Gekkio/gekkio-kicad-libs/README.markdown

# KiCad 10.x libraries by gekkio

Licensed under Creative Commons Attribution 4.0 International.

## Symbols

<!-- SYMBOLS START -->
| Name | Description | Datasheet |
| - | - | - |
| 10M02SCE144 | MAX 10 FPGA, 2000 LE, single supply, EQFP-144 | [Datasheet](https://www.intel.com/content/dam/www/programmable/us/en/pdfs/literature/hb/max-10/m10_overview.pdf) |
| 10M04DAF256 | MAX 10 FPGA, 4000 LE, dual supply, analog and flash, FBGA-256 | [Datasheet](https://www.intel.com/content/dam/www/programmable/us/en/pdfs/literature/hb/max-10/m10_overview.pdf) |
| 10M04SAE144 | MAX 10 FPGA, 4000 LE, single supply, analog and flash, EQFP-144 | [Datasheet](https://www.intel.com/content/dam/www/programmable/us/en/pdfs/literature/hb/max-10/m10_overview.pdf) |
| 10M04SCE144 | MAX 10 FPGA, 4000 LE, single supply, EQFP-144 | [Datasheet](https://www.intel.com/content/dam/www/programmable/us/en/pdfs/literature/hb/max-10/m10_overview.pdf) |
| 10M08DAF256 | MAX 10 FPGA, 8000 LE, dual supply, analog and flash, FBGA-256 | [Datasheet](https://www.intel.com/content/dam/www/programmable/us/en/pdfs/literature/hb/max-10/m10_overview.pdf) |
| 10M08SAE144 | MAX 10 FPGA, 8000 LE, single supply, analog and flash, EQFP-144 | [Datasheet](https://www.intel.com/content/dam/www/programmable/us/en/pdfs/literature/hb/max-10/m10_overview.pdf) |
| 10M08SCE144 | MAX 10 FPGA, 8000 LE, single supply, EQFP-144 | [Datasheet](https://www.intel.com/content/dam/www/programmable/us/en/pdfs/literature/hb/max-10/m10_overview.pdf) |
| 10M16DAF256 | MAX 10 FPGA, 16000 LE, dual supply, analog and flash, FBGA-256 | [Datasheet](https://www.intel.com/content/dam/www/programmable/us/en/pdfs/literature/hb/max-10/m10_overview.pdf) |
| 10M16SAE144 | MAX 10 FPGA, 16000 LE, single supply, analog and flash, EQFP-144 | [Datasheet](https://www.intel.com/content/dam/www/programmable/us/en/pdfs/literature/hb/max-10/m10_overview.pdf) |
| 10M16SCE144 | MAX 10 FPGA, 16000 LE, single supply, EQFP-144 | [Datasheet](https://www.intel.com/content/dam/www/programmable/us/en/pdfs/literature/hb/max-10/m10_overview.pdf) |
| 10M25DAF256 | MAX 10 FPGA, 25000 LE, dual supply, analog and flash, FBGA-256 | [Datasheet](https://www.intel.com/content/dam/www/programmable/us/en/pdfs/literature/hb/max-10/m10_overview.pdf) |
| 10M25SAE144 | MAX 10 FPGA, 25000 LE, single supply, analog and flash, EQFP-144 | [Datasheet](https://www.intel.com/content/dam/www/programmable/us/en/pdfs/literature/hb/max-10/m10_overview.pdf) |
| 10M25SCE144 | MAX 10 FPGA, 25000 LE, single supply, EQFP-144 | [Datasheet](https://www.intel.com/content/dam/www/programmable/us/en/pdfs/literature/hb/max-10/m10_overview.pdf) |
| 10M40DAF256 | MAX 10 FPGA, 40000 LE, dual supply, analog and flash, FBGA-256 | [Datasheet](https://www.intel.com/content/dam/www/programmable/us/en/pdfs/literature/hb/max-10/m10_overview.pdf) |
| 10M50DAF256 | MAX 10 FPGA, 50000 LE, dual supply, analog and flash, FBGA-256 | [Datasheet](https://www.intel.com/content/dam/www/programmable/us/en/pdfs/literature/hb/max-10/m10_overview.pdf) |
| 1SS294 | 40V 0.1A Small signal Schottky diode, SOT-23 | [Datasheet](https://toshiba.semicon-storage.com/info/docget.jsp?did=3290&prodName=1SS294) |
| 23K256xSN | 256k SPI Bus Low-Power Serial SRAM, SOIC-8 | [Datasheet](http://ww1.microchip.com/downloads/en/DeviceDoc/22100F.pdf) |
| 23K256xST | 256k SPI Bus Low-Power Serial SRAM, TSSOP-8 | [Datasheet](http://ww1.microchip.com/downloads/en/DeviceDoc/22100F.pdf) |
| 5M160ZE64 | MAX V CPLD, 160 LE, EQFP-64 | [Datasheet](https://www.intel.com/content/dam/www/programmable/us/en/pdfs/literature/hb/max-v/mv51001.pdf) |
| 5M40ZE64 | MAX V CPLD, 40 LE, EQFP-64 | [Datasheet](https://www.intel.com/content/dam/www/programmable/us/en/pdfs/literature/hb/max-v/mv51001.pdf) |
| 5M80ZE64 | MAX V CPLD, 80 LE, EQFP-64 | [Datasheet](https://www.intel.com/content/dam/www/programmable/us/en/pdfs/literature/hb/max-v/mv51001.pdf) |
| 74AXP4T245PW | 4-bit dual supply translating transceiver, 3-state, TSSOP-16 | [Datasheet](https://assets.nexperia.com/documents/data-sheet/74LVC_LVCH8T245.pdf) |
| 74AXP8T245PW | 8-bit dual supply translating transceiver, 3-state, TSSOP-24 | [Datasheet](https://assets.nexperia.com/documents/data-sheet/74LVC_LVCH8T245.pdf) |
| 74LV1T125GV | Single supply translating buffer/line driver, 3-state, SOT-23-5 | [Datasheet](https://assets.nexperia.com/documents/data-sheet/74LV1T125.pdf) |
| 74LV1T125GW | Single supply translating buffer/line driver, 3-state, SC-70-5 | [Datasheet](https://assets.nexperia.com/documents/data-sheet/74LV1T125.pdf) |
| 74LV1T126GV | Single supply translating buffer/line driver, 3-state, SOT-23-5 | [Datasheet](https://assets.nexperia.com/documents/data-sheet/74LV1T126.pdf) |
| 74LV1T126GW | Single supply translating buffer/line driver, 3-state, SC-70-5 | [Datasheet](https://assets.nexperia.com/documents/data-sheet/74LV1T126.pdf) |
| 74LVC125APW | Quad buffer/line driver, 3-state, TSSOP-14 | [Datasheet](https://assets.nexperia.com/documents/data-sheet/74LVC125A.pdf) |
| 74LVC126APW | Quad buffer/line driver, 3-state, TSSOP-14 | [Datasheet](https://assets.nexperia.com/documents/data-sheet/74LVC126A.pdf) |
| 74LVC16244ADGG | 16-bit buffer/line driver, 5V input/output tolerant, 3-state, TSSOP-48 | [Datasheet](https://assets.nexperia.com/documents/data-sheet/74LVC_LVCH16244A.pdf) |
| 74LVC16373ADGG | 16-bit D-type transparent latch with 5V tolerant inputs/outputs, 3-state, TSSOP-48 | [Datasheet](https://assets.nexperia.com/documents/data-sheet/74LVC_LVCH16373A.pdf) |
| 74LVC16373ADGV | 16-bit D-type transparent latch with 5V tolerant inputs/outputs, 3-state, TSSOP-48 | [Datasheet](https://assets.nexperia.com/documents/data-sheet/74LVC_LVCH16373A.pdf) |
| 74LVC16373ADL | 16-bit D-type transparent latch with 5V tolerant inputs/outputs, 3-state, SSOP-48 | [Datasheet](https://assets.nexperia.com/documents/data-sheet/74LVC_LVCH16373A.pdf) |
| 74LVC1G157GW | Single 2-input multiplexer, SOT-363 | [Datasheet](https://assets.nexperia.com/documents/data-sheet/74LVC1G157.pdf) |
| 74LVC244APW | Octal buffer/line driver, 3-state, TSSOP-20 | [Datasheet](https://assets.nexperia.com/documents/data-sheet/74LVC_LVCH244A.pdf) |
| 74LVC245APW | Octal bus transceiver, 3-state, TSSOP-20 | [Datasheet](https://assets.nexperia.com/documents/data-sheet/74LVC_LVCH245A.pdf) |
| 74LVC32AD | Quad 2-input OR gate, SO-14 | [Datasheet](https://assets.nexperia.com/documents/data-sheet/74LVC32A.pdf) |
| 74LVC32ADB | Quad 2-input OR gate, SSOP-14 | [Datasheet](https://assets.nexperia.com/documents/data-sheet/74LVC32A.pdf) |
| 74LVC32APW | Quad 2-input OR gate, TSSOP-14 | [Datasheet](https://assets.nexperia.com/documents/data-sheet/74LVC32A.pdf) |
| 74LVC4T3144PW | 4-bit dual supply buffer/line driver; 3-state | [Datasheet](https://assets.nexperia.com/documents/data-sheet/74LVC4T3144.pdf) |
| 74LVC540APW | Octal inverting buffer/line driver, 3-state, TSSOP-20 | [Datasheet](https://www.ti.com/lit/ds/symlink/sn74lvc540a.pdf) |
| 74LVC573ABQ | Octal D-type transparent latch with 5 V tolerant inputs/outputs, 3-state, DHVQFN-20 | [Datasheet](https://assets.nexperia.com/documents/data-sheet/74LVC573A.pdf) |
| 74LVC573AD | Octal D-type transparent latch with 5 V tolerant inputs/outputs, 3-state, SO-20 | [Datasheet](https://assets.nexperia.com/documents/data-sheet/74LVC573A.pdf) |
| 74LVC573ADB | Octal D-type transparent latch with 5 V tolerant inputs/outputs, 3-state, SSOP-20 | [Datasheet](https://assets.nexperia.com/documents/data-sheet/74LVC573A.pdf) |
| 74LVC573APW | Octal D-type transparent latch with 5 V tolerant inputs/outputs, 3-state, TSSOP-20 | [Datasheet](https://assets.nexperia.com/documents/data-sheet/74LVC573A.pdf) |
| 74LVC594AD | 8-bit shift register with output register, SO-16 | [Datasheet](https://assets.nexperia.com/documents/data-sheet/74LVC594A.pdf) |
| 74LVC594APW | 8-bit shift register with output register, TSSOP-16 | [Datasheet](https://assets.nexperia.com/documents/data-sheet/74LVC594A.pdf) |
| 74LVC595AD | 8-bit serial-in/serial-out or parallel-out shift register, 3-state, SO-16 | [Datasheet](https://assets.nexperia.com/documents/data-sheet/74LVC595A.pdf) |
| 74LVC595APW | 8-bit serial-in/serial-out or parallel-out shift register, 3-state, TSSOP-16 | [Datasheet](https://assets.nexperia.com/documents/data-sheet/74LVC595A.pdf) |
| 74LVC8T245PW | 8-bit dual supply translating transceiver, 3-state, TSSOP-24 | [Datasheet](https://assets.nexperia.com/documents/data-sheet/74LVC_LVCH8T245.pdf) |
| 74LVCH16244ADGG | 16-bit buffer/line driver, 5V input/output tolerant, 3-state, bus hold, TSSOP-48 | [Datasheet](https://assets.nexperia.com/documents/data-sheet/74LVC_LVCH16244A.pdf) |
| 74LVCH16373ADGG | 16-bit D-type transparent latch with 5V tolerant inputs/outputs, 3-state, bus hold, TSSOP-48 | [Datasheet](https://assets.nexperia.com/documents/data-sheet/74LVC_LVCH16373A.pdf) |
| 74LVCH16373ADGV | 16-bit D-type transparent latch with 5V tolerant inputs/outputs, 3-state, bus hold, TSSOP-48 | [Datasheet](https://assets.nexperia.com/documents/data-sheet/74LVC_LVCH16373A.pdf) |
| 74LVCH16373ADL | 16-bit D-type transparent latch with 5V tolerant inputs/outputs, 3-state, bus hold, SSOP-48 | [Datasheet](https://assets.nexperia.com/documents/data-sheet/74LVC_LVCH16373A.pdf) |
| 74LVCH244APW | Octal buffer/line driver, 3-state, bus hold, TSSOP-20 | [Datasheet](https://assets.nexperia.com/documents/data-sheet/74LVC_LVCH244A.pdf) |
| 74LVCH245APW | Octal bus transceiver, 3-state, bus hold, TSSOP-20 | [Datasheet](https://assets.nexperia.com/documents/data-sheet/74LVC_LVCH245A.pdf) |
| 74LVCH8T245PW | 8-bit dual supply translating transceiver, 3-state, bus hold, TSSOP-24 | [Datasheet](https://assets.nexperia.com/documents/data-sheet/74LVC_LVCH8T245.pdf) |
| 74VHC125PW | Quad buffer/line driver, 3-state, TSSOP-14 | [Datasheet](https://assets.nexperia.com/documents/data-sheet/74VHC_VHCT125.pdf) |
| 74VHC126PW | Quad buffer/line driver, 3-state, TSSOP-14 | [Datasheet](https://assets.nexperia.com/documents/data-sheet/74VHC_VHCT126.pdf) |
| 74VHCT125PW | Quad buffer/line driver, 3-state, TSSOP-14 | [Datasheet](https://assets.nexperia.com/documents/data-sheet/74VHC_VHCT125.pdf) |
| 74VHCT126PW | Quad buffer/line driver, 3-state, TSSOP-14 | [Datasheet](https://assets.nexperia.com/documents/data-sheet/74VHC_VHCT126.pdf) |
| 93LC56A-xOT | 2kb (256 x 8) 2.5V Microwire Compatible Serial EEPROM, SOT-23-6 | [Datasheet](http://ww1.microchip.com/downloads/en/devicedoc/21794b.pdf) |
| 93LC56B-xOT | 2kb (128 x 16) 2.5V Microwire Compatible Serial EEPROM, SOT-23-6 | [Datasheet](http://ww1.microchip.com/downloads/en/devicedoc/21794b.pdf) |
| AD8428 | Single Low Noise, Low Gain Drift, G=2000 Instrumentation Amplifier, SOIC-8 | [Datasheet](https://www.analog.com/media/en/technical-documentation/data-sheets/AD8428.PDF) |
| AD8428ARZ | Single Low Noise, Low Gain Drift, G=2000 Instrumentation Amplifier, A Grade, SOIC-8 | [Datasheet](https://www.analog.com/media/en/technical-documentation/data-sheets/AD8428.PDF) |
| AD8428BRZ | Single Low Noise, Low Gain Drift, G=2000 Instrumentation Amplifier, B Grade, SOIC-8 | [Datasheet](https://www.analog.com/media/en/technical-documentation/data-sheets/AD8428.PDF) |
| ADS1274 | Quad, Simultaneous Sampling, 24-Bit Analog-to-Digital Converters, HTQFP-64 | [Datasheet](http://www.ti.com/lit/ds/symlink/ads1274.pdf) |
| ADS1278 | Octal, Simultaneous Sampling, 24-Bit Analog-to-Digital Converters, HTQFP-64 | [Datasheet](http://www.ti.com/lit/ds/symlink/ads1278.pdf) |
| AP2114H-1.2 | 1.2V 1A Low Noise CMOS LDO Regulator, SOT-223 | [Datasheet](https://www.diodes.com/assets/Datasheets/AP2114.pdf) |
| AP2114H-1.5 | 1.5V 1A Low Noise CMOS LDO Regulator, SOT-223 | [Datasheet](https://www.diodes.com/assets/Datasheets/AP2114.pdf) |
| AP2114H-1.8 | 1.8V 1A Low Noise CMOS LDO Regulator, SOT-223 | [Datasheet](https://www.diodes.com/assets/Datasheets/AP2114.pdf) |
| AP2114H-2.5 | 2.5V 1A Low Noise CMOS LDO Regulator, SOT-223 | [Datasheet](https://www.diodes.com/assets/Datasheets/AP2114.pdf) |
| AP2114H-3.3 | 3.3V 1A Low Noise CMOS LDO Regulator, SOT-223 | [Datasheet](https://www.diodes.com/assets/Datasheets/AP2114.pdf) |
| AP2138N-1.2 | 1.2V 250mA Ultra Low Quiescent Current CMOS LDO, SOT-23-3 | [Datasheet](https://www.diodes.com/assets/Datasheets/AP2138-9.pdf) |
| AP2138N-1.4 | 1.4V 250mA Ultra Low Quiescent Current CMOS LDO, SOT-23-3 | [Datasheet](https://www.diodes.com/assets/Datasheets/AP2138-9.pdf) |
| AP2138N-1.5 | 1.5V 250mA Ultra Low Quiescent Current CMOS LDO, SOT-23-3 | [Datasheet](https://www.diodes.com/assets/Datasheets/AP2138-9.pdf) |
| AP2138N-1.8 | 1.8V 250mA Ultra Low Quiescent Current CMOS LDO, SOT-23-3 | [Datasheet](https://www.diodes.com/assets/Datasheets/AP2138-9.pdf) |
| AP2138N-2.1 | 2.1V 250mA Ultra Low Quiescent Current CMOS LDO, SOT-23-3 | [Datasheet](https://www.diodes.com/assets/Datasheets/AP2138-9.pdf) |
| AP2138N-2.2 | 2.2V 250mA Ultra Low Quiescent Current CMOS LDO, SOT-23-3 | [Datasheet](https://www.diodes.com/assets/Datasheets/AP2138-9.pdf) |
| AP2138N-2.5 | 2.5V 250mA Ultra Low Quiescent Current CMOS LDO, SOT-23-3 | [Datasheet](https://www.diodes.com/assets/Datasheets/AP2138-9.pdf) |
| AP2138N-2.8 | 2.8V 250mA Ultra Low Quiescent Current CMOS LDO, SOT-23-3 | [Datasheet](https://www.diodes.com/assets/Datasheets/AP2138-9.pdf) |
| AP2138N-3.0 | 3.0V 250mA Ultra Low Quiescent Current CMOS LDO, SOT-23-3 | [Datasheet](https://www.diodes.com/assets/Datasheets/AP2138-9.pdf) |
| AP2138N-3.3 | 3.3V 250mA Ultra Low Quiescent Current CMOS LDO, SOT-23-3 | [Datasheet](https://www.diodes.com/assets/Datasheets/AP2138-9.pdf) |
| AP2138N-3.6 | 3.6V 250mA Ultra Low Quiescent Current CMOS LDO, SOT-23-3 | [Datasheet](https://www.diodes.com/assets/Datasheets/AP2138-9.pdf) |
| AP2139AK-1.2 | 1.2V 250mA Ultra Low Quiescent Current CMOS LDO, Active High Enable with Quick Discharge, SOT-23-5 | [Datasheet](https://www.diodes.com/assets/Datasheets/AP2138-9.pdf) |
| AP2139AK-1.4 | 1.4V 250mA Ultra Low Quiescent Current CMOS LDO, Active High Enable with Quick Discharge, SOT-23-5 | [Datasheet](https://www.diodes.com/assets/Datasheets/AP2138-9.pdf) |
| AP2139AK-1.5 | 1.5V 250mA Ultra Low Quiescent Current CMOS LDO, Active High Enable with Quick Discharge, SOT-23-5 | [Datasheet](https://www.diodes.com/assets/Datasheets/AP2138-9.pdf) |
| AP2139AK-1.8 | 1.8V 250mA Ultra Low Quiescent Current CMOS LDO, Active High Enable with Quick Discharge, SOT-23-5 | [Datasheet](https://www.diodes.com/assets/Datasheets/AP2138-9.pdf) |
| AP2139AK-2.5 | 2.5V 250mA Ultra Low Quiescent Current CMOS LDO, Active High Enable with Quick Discharge, SOT-23-5 | [Datasheet](https://www.diodes.com/assets/Datasheets/AP2138-9.pdf) |
| AP2139AK-2.8 | 2.8V 250mA Ultra Low Quiescent Current CMOS LDO, Active High Enable with Quick Discharge, SOT-23-5 | [Datasheet](https://www.diodes.com/assets/Datasheets/AP2138-9.pdf) |
| AP2139AK-3.0 | 3.0V 250mA Ultra Low Quiescent Current CMOS LDO, Active High Enable with Quick Discharge, SOT-23-5 | [Datasheet](https://www.diodes.com/assets/Datasheets/AP2138-9.pdf) |
| AP2139AK-3.3 | 3.3V 250mA Ultra Low Quiescent Current CMOS LDO, Active High Enable with Quick Discharge, SOT-23-5 | [Datasheet](https://www.diodes.com/assets/Datasheets/AP2138-9.pdf) |
| AP2205-18W5-7 | 1.8V, 200mA, wide input voltage range ULDO regulator, SOT-23-5 | [Datasheet](https://www.diodes.com/assets/Datasheets/AP2205.pdf) |
| AP3019AK | White LED step-up converter, SOT-23-6 | [Datasheet](https://www.diodes.com/assets/Datasheets/AP3019A.pdf) |
| AP3019AKT | White LED step-up converter, TSOT-23-6 | [Datasheet](https://www.diodes.com/assets/Datasheets/AP3019A.pdf) |
| AP4953GM | Dual P-Channel Enchancement Mode MOSFET, SOIC-8 | [Datasheet](https://datasheet.lcsc.com/szlcsc/Advanced-Power-Elec-AP4953GM_C6193.pdf) |
| AP61100 | 2.3V to 5.5V Input, 1A Low IQ Synchronous Buck Converter, SOT-563 | [Datasheet](https://www.diodes.com/assets/Datasheets/AP61100-AP61102.pdf) |
| AP61102 | 2.3V to 5.5V Input, 1A Low IQ Synchronous Buck Converter, with Power Good, SOT-563 | [Datasheet](https://www.diodes.com/assets/Datasheets/AP61100-AP61102.pdf) |
| AS4C16M16SA | 256Mb (16M x 16) Synchronous DRAM, TSOP-II 54-pin | [Datasheet](https://www.alliancememory.com/wp-content/uploads/pdf/dram/256Mb-AS4C16M16SA-C&I_V3.0_March%202015.pdf) |
| AT49F001-xxJx | 1Mb (128K x 8) 5-volt Only Flash Memory, PLCC-32 | [Datasheet](https://datasheet.octopart.com/AT49F001-55PC-Atmel-datasheet-10108.pdf) |
| AT49F001N-xxJx | 1Mb (128K x 8) 5-volt Only Flash Memory, PLCC-32 | [Datasheet](https://datasheet.octopart.com/AT49F001-55PC-Atmel-datasheet-10108.pdf) |
| AT49F001NT-xxJx | 1Mb (128K x 8) 5-volt Only Flash Memory, PLCC-32 | [Datasheet](https://datasheet.octopart.com/AT49F001-55PC-Atmel-datasheet-10108.pdf) |
| AT49F001T-xxJx | 1Mb (128K x 8) 5-volt Only Flash Memory, PLCC-32 | [Datasheet](https://datasheet.octopart.com/AT49F001-55PC-Atmel-datasheet-10108.pdf) |
| AT49F002-xxJx | 2Mb (256K x 8) 5-volt Only Flash Memory, PLCC-32 | [Datasheet](https://datasheet.octopart.com/AT49F002T-90JC-Atmel-datasheet-821.pdf) |
| AT49F002N-xxJx | 2Mb (256K x 8) 5-volt Only Flash Memory, PLCC-32 | [Datasheet](https://datasheet.octopart.com/AT49F002T-90JC-Atmel-datasheet-821.pdf) |
| AT49F002NT-xxJx | 2Mb (256K x 8) 5-volt Only Flash Memory, PLCC-32 | [Datasheet](https://datasheet.octopart.com/AT49F002T-90JC-Atmel-datasheet-821.pdf) |
| AT49F002T-xxJx | 2Mb (256K x 8) 5-volt Only Flash Memory, PLCC-32 | [Datasheet](https://datasheet.octopart.com/AT49F002T-90JC-Atmel-datasheet-821.pdf) |
| ATA6561-GAQW | High-Speed CAN Transceiver with Standby Mode, CAN FD Ready, SOIC-8 | [Datasheet](https://ww1.microchip.com/downloads/en/DeviceDoc/20005991B.pdf) |
| ATF1504AS-xAx100 | High-performance Complex Programmable Logic Device, 64 Macrocells, TQFP-100 | [Datasheet](http://ww1.microchip.com/downloads/en/DeviceDoc/doc0784.pdf) |
| ATF1504ASL-xAx100 | High-performance Complex Programmable Logic Device, 64 Macrocells, TQFP-100 | [Datasheet](http://ww1.microchip.com/downloads/en/DeviceDoc/doc0784.pdf) |
| ATF1508AS-xAx100 | High-performance Complex Programmable Logic Device, 128 Macrocells, TQFP-100 | [Datasheet](http://ww1.microchip.com/downloads/en/DeviceDoc/doc0784.pdf) |
| ATF1508ASL-xAx100 | High-performance Complex Programmable Logic Device, 128 Macrocells, TQFP-100 | [Datasheet](http://ww1.microchip.com/downloads/en/DeviceDoc/doc0784.pdf) |
| ATSAM3U1Cx-AU | SAM3U SMART ARM-based Flash MCU, 96MHz, 64kB Flash, 20kB RAM, TQFP-100 | [Datasheet](https://ww1.microchip.com/downloads/en/DeviceDoc/Atmel-6430-32-bit-Cortex-M3-Microcontroller-SAM3U4-SAM3U2-SAM3U1_Datasheet.pdf) |
| BA3258HFP | 3.3V/1.5V 1A, Dual Output Fixed Output LDO Regulator, HRP5 | [Datasheet](http://rohmfs.rohm.com/en/products/databook/datasheet/ic/power/linear_regulator/ba3258hfp-e.pdf) |
| BA33D15HFP | 3.3V/1.5V 0.5A, Dual Output Fixed Output LDO Regulator, HRP5 | [Datasheet](http://rohmfs.rohm.com/en/products/databook/datasheet/ic/power/linear_regulator/ba3258hfp-e.pdf) |
| BA33D18HFP | 3.3V/1.8V 0.5A, Dual Output Fixed Output LDO Regulator, HRP5 | [Datasheet](http://rohmfs.rohm.com/en/products/databook/datasheet/ic/power/linear_regulator/ba3258hfp-e.pdf) |
| BCR401W | LED Driver, SC-82 | [Datasheet](https://www.infineon.com/dgdl/Infineon-BCR401W-DS-v02_00-en.pdf?fileId=db3a30431400ef68011407b0f84a0188) |
| BT832 | Ultra low power Bluetooth Low Energy (BLE) module with Nordic nRF52832 SoC | [Datasheet](https://www.fanstel.com/s/BT832_datasheets.pdf) |
| BT832A | Ultra low power Bluetooth Low Energy (BLE) module with Nordic nRF52810 SoC | [Datasheet](https://www.fanstel.com/s/BT832_datasheets.pdf) |
| BT832AF | Ultra low power Bluetooth Low Energy (BLE) module with Nordic nRF52810 SoC | [Datasheet](https://www.fanstel.com/s/BT832_datasheets.pdf) |
| BT832F | Ultra low power Bluetooth Low Energy (BLE) module with Nordic nRF52832 SoC | [Datasheet](https://www.fanstel.com/s/BT832_datasheets.pdf) |
| BU4809G | Low Voltage Standard CMOS Voltage Detector, 0.9V threshold, active low output (open drain), SOT-23-5 | [Datasheet](http://rohmfs.rohm.com/en/products/databook/datasheet/ic/power/voltage_detector/bu48xxg-e.pdf) |
| BU4810G | Low Voltage Standard CMOS Voltage Detector, 1.0V threshold, active low output (open drain), SOT-23-5 | [Datasheet](http://rohmfs.rohm.com/en/products/databook/datasheet/ic/power/voltage_detector/bu48xxg-e.pdf) |
| BU4811G | Low Voltage Standard CMOS Voltage Detector, 1.1V threshold, active low output (open drain), SOT-23-5 | [Datasheet](http://rohmfs.rohm.com/en/products/databook/datasheet/ic/power/voltage_detector/bu48xxg-e.pdf) |
| BU4812G | Low Voltage Standard CMOS Voltage Detector, 1.2V threshold, active low output (open drain), SOT-23-5 | [Datasheet](http://rohmfs.rohm.com/en/products/databook/datasheet/ic/power/voltage_detector/bu48xxg-e.pdf) |
| BU4813G | Low Voltage Standard CMOS Voltage Detector, 1.3V threshold, active low output (open drain), SOT-23-5 | [Datasheet](http://rohmfs.rohm.com/en/products/databook/datasheet/ic/power/voltage_detector/bu48xxg-e.pdf) |
| BU4814G | Low Voltage Standard CMOS Voltage Detector, 1.4V threshold, active low output (open drain), SOT-23-5 | [Datasheet](http://rohmfs.rohm.com/en/products/databook/datasheet/ic/power/voltage_detector/bu48xxg-e.pdf) |
| BU4815G | Low Voltage Standard CMOS Voltage Detector, 1.5V threshold, active low output (open drain), SOT-23-5 | [Datasheet](http://rohmfs.rohm.com/en/products/databook/datasheet/ic/power/voltage_detector/bu48xxg-e.pdf) |
| BU4816G | Low Voltage Standard CMOS Voltage Detector, 1.6V threshold, active low output (open drain), SOT-23-5 | [Datasheet](http://rohmfs.rohm.com/en/products/databook/datasheet/ic/power/voltage_detector/bu48xxg-e.pdf) |
| BU4817G | Low Voltage Standard CMOS Voltage Detector, 1.7V threshold, active low output (open drain), SOT-23-5 | [Datasheet](http://rohmfs.rohm.com/en/products/databook/datasheet/ic/power/voltage_detector/bu48xxg-e.pdf) |
| BU4818G | Low Voltage Standard CMOS Voltage Detector, 1.8V threshold, active low output (open drain), SOT-23-5 | [Datasheet](http://rohmfs.rohm.com/en/products/databook/datasheet/ic/power/voltage_detector/bu48xxg-e.pdf) |
| BU4819G | Low Voltage Standard CMOS Voltage Detector, 1.9V threshold, active low output (open drain), SOT-23-5 | [Datasheet](http://rohmfs.rohm.com/en/products/databook/datasheet/ic/power/voltage_detector/bu48xxg-e.pdf) |
| BU4820G | Low Voltage Standard CMOS Voltage Detector, 2.0V threshold, active low output (open drain), SOT-23-5 | [Datasheet](http://rohmfs.rohm.com/en/products/databook/datasheet/ic/power/voltage_detector/bu48xxg-e.pdf) |
| BU4821G | Low Voltage Standard CMOS Voltage Detector, 2.1V threshold, active low output (open drain), SOT-23-5 | [Datasheet](http://rohmfs.rohm.com/en/products/databook/datasheet/ic/power/voltage_detector/bu48xxg-e.pdf) |
| BU4822G | Low Voltage Standard CMOS Voltage Detector, 2.2V threshold, active low output (open drain), SOT-23-5 | [Datasheet](http://rohmfs.rohm.com/en/products/databook/datasheet/ic/power/voltage_detector/bu48xxg-e.pdf) |
| BU4823G | Low Voltage Standard CMOS Voltage Detector, 2.3V threshold, active low output (open drain), SOT-23-5 | [Datasheet](http://rohmfs.rohm.com/en/products/databook/datasheet/ic/power/voltage_detector/bu48xxg-e.pdf) |
| BU4824G | Low Voltage Standard CMOS Voltage Detector, 2.4V threshold, active low output (open drain), SOT-23-5 | [Datasheet](http://rohmfs.rohm.com/en/products/databook/datasheet/ic/power/voltage_detector/bu48xxg-e.pdf) |
| BU4825G | Low Voltage Standard CMOS Voltage Detector, 2.5V threshold, active low output (open drain), SOT-23-5 | [Datasheet](http://rohmfs.rohm.com/en/products/databook/datasheet/ic/power/voltage_detector/bu48xxg-e.pdf) |
| BU4826G | Low Voltage Standard CMOS Voltage Detector, 2.6V threshold, active low output (open drain), SOT-23-5 | [Datasheet](http://rohmfs.rohm.com/en/products/databook/datasheet/ic/power/voltage_detector/bu48xxg-e.pdf) |
| BU4827G | Low Voltage Standard CMOS Voltage Detector, 2.7V threshold, active low output (open drain), SOT-23-5 | [Datasheet](http://rohmfs.rohm.com/en/products/databook/datasheet/ic/power/voltage_detector/bu48xxg-e.pdf) |
| BU4828G | Low Voltage Standard CMOS Voltage Detector, 2.8V threshold, active low output (open drain), SOT-23-5 | [Datasheet](http://rohmfs.rohm.com/en/products/databook/datasheet/ic/power/voltage_detector/bu48xxg-e.pdf) |
| BU4829G | Low Voltage Standard CMOS Voltage Detector, 2.9V threshold, active low output (open drain), SOT-23-5 | [Datasheet](http://rohmfs.rohm.com/en/products/databook/datasheet/ic/power/voltage_detector/bu48xxg-e.pdf) |
| BU4830G | Low Voltage Standard CMOS Voltage Detector, 3.0V threshold, active low output (open drain), SOT-23-5 | [Datasheet](http://rohmfs.rohm.com/en/products/databook/datasheet/ic/power/voltage_detector/bu48xxg-e.pdf) |
| BU4831G | Low Voltage Standard CMOS Voltage Detector, 3.1V threshold, active low output (open drain), SOT-23-5 | [Datasheet](http://rohmfs.rohm.com/en/products/databook/datasheet/ic/power/voltage_detector/bu48xxg-e.pdf) |
| BU4832G | Low Voltage Standard CMOS Voltage Detector, 3.2V threshold, active low output (open drain), SOT-23-5 | [Datasheet](http://rohmfs.rohm.com/en/products/databook/datasheet/ic/power/voltage_detector/bu48xxg-e.pdf) |
| BU4833G | Low Voltage Standard CMOS Voltage Detector, 3.3V threshold, active low output (open drain), SOT-23-5 | [Datasheet](http://rohmfs.rohm.com/en/products/databook/datasheet/ic/power/voltage_detector/bu48xxg-e.pdf) |
| BU4834G | Low Voltage Standard CMOS Voltage Detector, 3.4V threshold, active low output (open drain), SOT-23-5 | [Datasheet](http://rohmfs.rohm.com/en/products/databook/datasheet/ic/power/voltage_detector/bu48xxg-e.pdf) |
| BU4835G | Low Voltage Standard CMOS Voltage Detector, 3.5V threshold, active low output (open drain), SOT-23-5 | [Datasheet](http://rohmfs.rohm.com/en/products/databook/datasheet/ic/power/voltage_detector/bu48xxg-e.pdf) |
| BU4836G | Low Voltage Standard CMOS Voltage Detector, 3.6V threshold, active low output (open drain), SOT-23-5 | [Datasheet](http://rohmfs.rohm.com/en/products/databook/datasheet/ic/power/voltage_detector/bu48xxg-e.pdf) |
| BU4837G | Low Voltage Standard CMOS Voltage Detector, 3.7V threshold, active low output (open drain), SOT-23-5 | [Datasheet](http://rohmfs.rohm.com/en/products/databook/datasheet/ic/power/voltage_detector/bu48xxg-e.pdf) |
| BU4838G | Low Voltage Standard CMOS Voltage Detector, 3.8V threshold, active low output (open drain), SOT-23-5 | [Datasheet](http://rohmfs.rohm.com/en/products/databook/datasheet/ic/power/voltage_detector/bu48xxg-e.pdf) |
| BU4839G | Low Voltage Standard CMOS Voltage Detector, 3.9V threshold, active low output (open drain), SOT-23-5 | [Datasheet](http://rohmfs.rohm.com/en/products/databook/datasheet/ic/power/voltage_detector/bu48xxg-e.pdf) |
| BU4840G | Low Voltage Standard CMOS Voltage Detector, 4.0V threshold, active low output (open drain), SOT-23-5 | [Datasheet](http://rohmfs.rohm.com/en/products/databook/datasheet/ic/power/voltage_detector/bu48xxg-e.pdf) |
| BU4841G | Low Voltage Standard CMOS Voltage Detector, 4.1V threshold, active low output (open drain), SOT-23-5 | [Datasheet](http://rohmfs.rohm.com/en/products/databook/datasheet/ic/power/voltage_detector/bu48xxg-e.pdf) |
| BU4842G | Low Voltage Standard CMOS Voltage Detector, 4.2V threshold, active low output (open drain), SOT-23-5 | [Datasheet](http://rohmfs.rohm.com/en/products/databook/datasheet/ic/power/voltage_detector/bu48xxg-e.pdf) |
| BU4843G | Low Voltage Standard CMOS Voltage Detector, 4.3V threshold, active low output (open drain), SOT-23-5 | [Datasheet](http://rohmfs.rohm.com/en/products/databook/datasheet/ic/power/voltage_detector/bu48xxg-e.pdf) |
| BU4844G | Low Voltage Standard CMOS Voltage Detector, 4.4V threshold, active low output (open drain), SOT-23-5 | [Datasheet](http://rohmfs.rohm.com/en/products/databook/datasheet/ic/power/voltage_detector/bu48xxg-e.pdf) |
| BU4845G | Low Voltage Standard CMOS Voltage Detector, 4.5V threshold, active low output (open drain), SOT-23-5 | [Datasheet](http://rohmfs.rohm.com/en/products/databook/datasheet/ic/power/voltage_detector/bu48xxg-e.pdf) |
| BU4846G | Low Voltage Standard CMOS Voltage Detector, 4.6V threshold, active low output (open drain), SOT-23-5 | [Datasheet](http://rohmfs.rohm.com/en/products/databook/datasheet/ic/power/voltage_detector/bu48xxg-e.pdf) |
| BU4847G | Low Voltage Standard CMOS Voltage Detector, 4.7V threshold, active low output (open drain), SOT-23-5 | [Datasheet](http://rohmfs.rohm.com/en/products/databook/datasheet/ic/power/voltage_detector/bu48xxg-e.pdf) |
| BU4848G | Low Voltage Standard CMOS Voltage Detector, 4.8V threshold, active low output (open drain), SOT-23-5 | [Datasheet](http://rohmfs.rohm.com/en/products/databook/datasheet/ic/power/voltage_detector/bu48xxg-e.pdf) |
| Bus_PCIExpress_1x | PCI Express 1x connector | [Datasheet](https://en.wikipedia.org/wiki/PCI_Express) |
| Bus_PCIExpress_4x | PCI Express 4x connector | [Datasheet](https://en.wikipedia.org/wiki/PCI_Express) |
| Bus_PCIExpress_8x | PCI Express 8x connector | [Datasheet](https://en.wikipedia.org/wiki/PCI_Express) |
| CBT3125PW | Quadruple FET bus switch, TSSOP-14 | [Datasheet](https://assets.nexperia.com/documents/data-sheet/CBT3125.pdf) |
| CY62126EV30LL-xxBV | 1Mb (64k x 16) SRAM, VFBGA-48 | [Datasheet](https://www.cypress.com/file/43721/download) |
| CY62157EV18LL-xxBV | 8Mb (512k x 16) SRAM, 1.8V, VFBGA-48 | [Datasheet](https://www.infineon.com/dgdl/Infineon-CY62157EV18_MOBL_8_MBIT_(512K_X_16)_STATIC_RAM-DataSheet-v15_00-EN.pdf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) |
| DA101JC | SM Transformer for Digital Audio Data Transmission, 1:1, 1.00-2.20 mH | [Datasheet](https://www.murata.com/products/productdata/8816046145566/kmp-da100j.pdf) |
| DA102JC | SM Transformer for Digital Audio Data Transmission, 1:1, 2.00-4.40 mH | [Datasheet](https://www.murata.com/products/productdata/8816046145566/kmp-da100j.pdf) |
| DA103JC | SM Transformer for Digital Audio Data Transmission, 1:1, 3.20-8.50 mH | [Datasheet](https://www.murata.com/products/productdata/8816046145566/kmp-da100j.pdf) |
| DMN3026LVT | 6.6A Id, 30V Vds, N-Channel MOSFET, TSOT-23-6 | [Datasheet](https://www.diodes.com/assets/Datasheets/DMN3026LVT.pdf) |
| DRV8426RGER | Stepper Driver With Integrated Current Sense, 1/256 Microstepping, STEP/DIR Interface and smart tune Technology, VQFN-24 | [Datasheet](https://www.ti.com/lit/ds/symlink/drv8426.pdf) |
| F411A | Nintendo F411A, SNES CIC chip (Sharp SM595), SSOP-18 |  |
| FGPMMOPA6H | GPS Module | [Datasheet](https://cdn-shop.adafruit.com/datasheets/GlobalTop-FGPMMOPA6H-Datasheet-V0A.pdf) |
| FMN1 | High-speed switching diodes 2 pair Com K, SOT-23-5 | [Datasheet](https://fscdn.rohm.com/en/products/databook/datasheet/discrete/diode/switching/fmn1t148-e.pdf) |
| FerriteBead_Pack04 | 4 ferrite bead array, parallel topology |  |
| FerriteBead_Pack04_Split | 4 ferrite bead array, parallel topology, split |  |
| Filter_EMI_LLL | EMI 3-inductor filter |  |
| GameBoyAdvance_Cartridge_MountingPin | Game Boy cartridge edge connector with mounting pin |  |
| GameBoyAdvance_SRAM_2M | 2Mb (128k x 16) Game Boy SRAM chip |  |
| GameBoy_Amplifier_AGB | Audio amplifier, Game Boy Advance (AGB), SSOP-18 |  |
| GameBoy_AudioJack3_SPST | Audio Jack, 3 Poles (Stereo / TRS), isolated SPST switch |  |
| GameBoy_Barrel_Jack_DMG | DC Barrel Jack, original Game Boy (DMG) |  |
| GameBoy_CPU_AGB-B | CPU, Game Boy Advance SP (AGS), QFP-156 |  |
| GameBoy_CPU_CGB | CPU, Game Boy Color (CGB), QFP-128 |  |
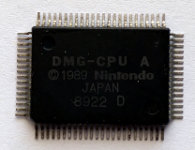
[picture p1: photos/GameBoy_CPU_DMG.jpg]
GameBoy_CPU_DMG
| GameBoy_CPU_DMG <br>  | CPU, original Game Boy (DMG), QFP-80 |  |
| GameBoy_CPU_MGB | CPU, Game Boy Pocket (MGB), Game Boy Light (MGL), QFP-80 |  |
| GameBoy_CPU_SGB | CPU, Super Game Boy (SGB), QFP-80 |  |
| GameBoy_CPU_SGB2 | CPU, Super Game Boy 2 (SGB2), QFP-80 |  |
| GameBoy_Cartridge | Game Boy cartridge edge connector |  |
| GameBoy_Cartridge_MountingPin | Game Boy cartridge edge connector with mounting pin |  |
| GameBoy_LinkPort | Game Boy link port |  |
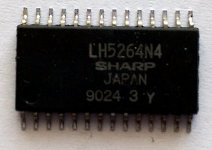
[picture p2: photos/GameBoy_SRAM_64K.jpg]
GameBoy_SRAM_64K
| GameBoy_SRAM_64K <br>  | 64kb (8K x 8) Game Boy SRAM chip, SOIC-28W |  |
| GameBoy_SW_DP3T_MGL | Double Pole Triple Throw (DP3T) Switch, Game Boy Light (MGL) |  |
| GameBoy_SW_DPDT_AGS | Double Pole Double Throw (DPDT) Switch, Game Boy Advance SP (AGS) |  |
| GameBoy_SW_DPDT_DMG | Double Pole Double Throw (DPDT) Switch, original Game Boy (DMG) |  |
| GameBoy_SW_SP3T_MGB | Single Pole Triple Throw (SP3T) Switch, Game Boy Pocket (MGB) |  |
| GameBoy_SW_SPDT_AGS | Single Pole Double Throw (SPDT) Switch, Game Boy Advance SP (AGS) |  |
| GameBoy_Transformer_0077 | Power Transformer "0077" |  |
| GameBoy_Transformer_066 | Power Transformer "066" |  |
| GameBoy_Transformer_AGS | Power Transformer, Game Boy Advance SP (AGS) |  |
| GameBoy_Transformer_DMG | Power Transformer, original Game Boy (DMG) |  |
| ICD2 |  |  |
| ICE40LP1K-QN84 | iCE40 LP FPGA, 1280 LUTs, 1.2V, QFN-84 | [Datasheet](http://www.latticesemi.com/Products/FPGAandCPLD/iCE40) |
| IQXO-791 | HCMOS Crystal Clock Oscillator, 3.3V | [Datasheet](https://www.iqdfrequencyproducts.com/products/details/iqxo-79x.pdf) |
| IQXO-793 | HCMOS Crystal Clock Oscillator, 2.5V | [Datasheet](https://www.iqdfrequencyproducts.com/products/details/iqxo-79x.pdf) |
| IQXO-794 | HCMOS Crystal Clock Oscillator, 1.8V | [Datasheet](https://www.iqdfrequencyproducts.com/products/details/iqxo-79x.pdf) |
| IR3E02 | LCD bias regulator, original Game Boy (DMG) |  |
| IR3R40N | Audio amplifier, original Game Boy (DMG), SSOP-18 |  |
| IR3R53N | Audio amplifier, Game Boy Pocket (MGB), SSOP-18 |  |
| IS61C1024AL-12T | 1Mb (128k x 8), 5V, 12ns, High-Speed CMOS Static RAM, TSOP-I 32-pin | [Datasheet](http://www.issi.com/WW/pdf/62-65C1024AL.pdf) |
| IS61C256AL-xxJ | 256kb (32K x 8), 5V, 10/12 ns, High-Speed CMOS Static RAM, SOIC-28W | [Datasheet](http://www.issi.com/WW/pdf/61C256AL.pdf) |
| IS61C256AL-xxT | 256kb (32k x 8), 5V, 10/12 ns, High-Speed CMOS Static RAM, TSOP-I 28-pin | [Datasheet](http://www.issi.com/WW/pdf/61C256AL.pdf) |
| IS61C64AL-10J | 64kb (8k x 8), 5V, 10ns, Low Voltage CMOS Static RAM, SOIC-28W | [Datasheet](http://www.issi.com/WW/pdf/61C64AL.pdf) |
| IS61C64AL-10T | 64kb (8k x 8), 5V, 10ns, Low Voltage CMOS Static RAM, TSOP-I 28-pin | [Datasheet](http://www.issi.com/WW/pdf/61C64AL.pdf) |
| IS61LV256AL-10J | 256kb (32K x 8), 3.3V, 10ns, Low Voltage CMOS Static RAM, SOIC-28W | [Datasheet](http://www.issi.com/WW/pdf/61LV256AL.pdf) |
| IS61LV256AL-10T | 256kb (32k x 8), 3.3V, 10ns, Low Voltage CMOS Static RAM, TSOP-I 28-pin | [Datasheet](http://www.issi.com/WW/pdf/61LV256AL.pdf) |
| IS62C1024AL-35Q | 1Mb (128k x 8), 5V, 35ns, Low Power CMOS Static RAM, SOP-32 | [Datasheet](http://www.issi.com/WW/pdf/62-65C1024AL.pdf) |
| IS62C1024AL-35T | 1Mb (128k x 8), 5V, 35ns, Low Power CMOS Static RAM, TSOP-I 32-pin | [Datasheet](http://www.issi.com/WW/pdf/62-65C1024AL.pdf) |
| IS62C256AL-xxT | 256kb (32k x 8), 5V, 25/45ns, Low Power CMOS Static RAM, TSOP-I 28-pin | [Datasheet](http://www.issi.com/WW/pdf/61C256AL.pdf) |
| IS62LV256AL-20J | 256kb (32K x 8), 3.3V, 20ns, Low Voltage CMOS Static RAM, SOIC-28W | [Datasheet](http://www.issi.com/WW/pdf/62-65LV256AL.pdf) |
| IS62LV256AL-xxT | 256kb (32k x 8), 3.3V, 20/45ns, Low Voltage CMOS Static RAM, TSOP-I 28-pin | [Datasheet](http://www.issi.com/WW/pdf/62-65LV256AL.pdf) |
| IS62WV10248EALL-55T | 8Mb (1M x 8), 1.65-2.2V, 55ns, Low Voltage Ulta Low Power CMOS Static RAM, TSOP-II 44-pin | [Datasheet](http://www.issi.com/WW/pdf/62-65WV10248EALL-BLL.pdf) |
| IS62WV10248EBLL-xxT | 8Mb (1M x 8), 2.2-3.6V, 45/55ns, Low Voltage Ulta Low Power CMOS Static RAM, TSOP-II 44-pin | [Datasheet](http://www.issi.com/WW/pdf/62-65WV10248EALL-BLL.pdf) |
| IS62WV10248EFALL-55T | 8Mb (1M x 8), 1.65-2.2V, 55ns, Low Voltage Ulta Low Power CMOS Static RAM, TSOP-II 44-pin | [Datasheet](http://www.issi.com/WW/pdf/62-65WV10248EFALL-BLL.pdf) |
| IS62WV10248EFBLL-45T | 8Mb (1M x 8), 2.2-3.6V, 45ns, Low Voltage Ulta Low Power CMOS Static RAM, TSOP-II 44-pin | [Datasheet](http://www.issi.com/WW/pdf/62-65WV10248EFALL-BLL.pdf) |
| IS62WV10248HALL-55T | 8Mb (1M x 8), 1.65-2.2V, 55ns, Low Voltage Ulta Low Power CMOS Static RAM, TSOP-II 44-pin | [Datasheet](http://www.issi.com/WW/pdf/62-65WV10248HALL-BLL.pdf) |
| IS62WV10248HBLL-45T | 8Mb (1M x 8), 2.2-3.6V, 45ns, Low Voltage Ulta Low Power CMOS Static RAM, TSOP-II 44-pin | [Datasheet](http://www.issi.com/WW/pdf/62-65WV10248HALL-BLL.pdf) |
| IS62WV1288DALL-55H | 1Mb (128k x 8), 1.65-2.2V, 55ns, Low Voltage Ultra Low Power CMOS Static RAM, sTSOP-I 32-pin | [Datasheet](http://www.issi.com/WW/pdf/62-65WV1288DALL-BLL.pdf) |
| IS62WV1288DALL-55T | 1Mb (128k x 8), 1.65-2.2V, 45ns, Low Voltage Ultra Low Power CMOS Static RAM, TSOP-I 32-pin | [Datasheet](http://www.issi.com/WW/pdf/62-65WV1288DALL-BLL.pdf) |
| IS62WV1288DBLL-45H | 1Mb (128k x 8), 2.3-3.6V, 45ns, Low Voltage Ultra Low Power CMOS Static RAM, sTSOP-I 32-pin | [Datasheet](http://www.issi.com/WW/pdf/62-65WV1288DALL-BLL.pdf) |
| IS62WV1288DBLL-45Q | 1Mb (128k x 8), 2.3-3.6V, 45ns, Low Voltage Ultra Low Power CMOS Static RAM, SOP-32 | [Datasheet](http://www.issi.com/WW/pdf/62-65WV1288DALL-BLL.pdf) |
| IS62WV1288DBLL-45T | 1Mb (128k x 8), 2.3-3.6V, 45ns, Low Voltage Ultra Low Power CMOS Static RAM, TSOP-I 32-pin | [Datasheet](http://www.issi.com/WW/pdf/62-65WV1288DALL-BLL.pdf) |
| IS62WV1288FALL-55H | 1Mb (128k x 8), 1.65-2.2V, 55ns, Low Voltage Ultra Low Power CMOS Static RAM, sTSOP-I 32-pin | [Datasheet](http://www.issi.com/WW/pdf/62-65WV1288FALL-BLL.pdf) |
| IS62WV1288FALL-55T | 1Mb (128k x 8), 1.65-2.2V, 55ns, Low Voltage Ultra Low Power CMOS Static RAM, TSOP-I 32-pin | [Datasheet](http://www.issi.com/WW/pdf/62-65WV1288FALL-BLL.pdf) |
| IS62WV1288FBLL-45H | 1Mb (128k x 8), 2.2-3.6V, 45ns, Low Voltage Ultra Low Power CMOS Static RAM, sTSOP-I 32-pin | [Datasheet](http://www.issi.com/WW/pdf/62-65WV1288FALL-BLL.pdf) |
| IS62WV1288FBLL-45Q | 1Mb (128k x 8), 2.2-3.6V, 45ns, Low Voltage Ultra Low Power CMOS Static RAM, SOP-32 | [Datasheet](http://www.issi.com/WW/pdf/62-65WV1288FALL-BLL.pdf) |
| IS62WV1288FBLL-45T | 1Mb (128k x 8), 2.2-3.6V, 45ns, Low Voltage Ultra Low Power CMOS Static RAM, TSOP-I 32-pin | [Datasheet](http://www.issi.com/WW/pdf/62-65WV1288FALL-BLL.pdf) |
| IS62WV2568ALL-70H | 2Mb (256k x 8), 1.65-2.2V, 70ns, Low Voltage Ultra Low Power CMOS Static RAM, sTSOP-I 32-pin | [Datasheet](http://www.issi.com/WW/pdf/62WV2568ALL_BLL.pdf) |
| IS62WV2568ALL-70T | 2Mb (256k x 8), 1.65-2.2V, 70ns, Low Voltage Ultra Low Power CMOS Static RAM, TSOP-I 32-pin | [Datasheet](http://www.issi.com/WW/pdf/62WV2568ALL_BLL.pdf) |
| IS62WV2568BLL-xxH | 2Mb (256k x 8), 2.5-3.6V, 45/55ns, Low Voltage Ultra Low Power CMOS Static RAM, sTSOP-I 32-pin | [Datasheet](http://www.issi.com/WW/pdf/62WV2568ALL_BLL.pdf) |
| IS62WV2568BLL-xxT | 2Mb (256k x 8), 2.5-3.6V, 45/55ns, Low Voltage Ultra Low Power CMOS Static RAM, TSOP-I 32-pin | [Datasheet](http://www.issi.com/WW/pdf/62WV2568ALL_BLL.pdf) |
| IS62WV2568EALL-55H | 2Mb (256k x 8), 1.65-2.2V, 55ns, Low Voltage Ultra Low Power CMOS Static RAM, sTSOP-I 32-pin | [Datasheet](http://www.issi.com/WW/pdf/62-65WV2568EALL-BLL.pdf) |
| IS62WV2568EALL-55T | 2Mb (256k x 8), 1.65-2.2V, 55ns, Low Voltage Ultra Low Power CMOS Static RAM, TSOP-I 32-pin | [Datasheet](http://www.issi.com/WW/pdf/62-65WV2568EALL-BLL.pdf) |
| IS62WV2568EBLL-45H | 2Mb (256k x 8), 2.2-3.6V, 45ns, Low Voltage Ultra Low Power CMOS Static RAM, sTSOP-I 32-pin | [Datasheet](http://www.issi.com/WW/pdf/62-65WV2568EALL-BLL.pdf) |
| IS62WV2568EBLL-45T | 2Mb (256k x 8), 2.2-3.6V, 45ns, Low Voltage Ultra Low Power CMOS Static RAM, TSOP-I 32-pin | [Datasheet](http://www.issi.com/WW/pdf/62-65WV2568EALL-BLL.pdf) |
| IS62WV2568FALL-55H | 2Mb (256k x 8), 1.65-2.2V, 55ns, Low Voltage Ultra Low Power CMOS Static RAM, sTSOP-I 32-pin | [Datasheet](http://www.issi.com/WW/pdf/62-65WV2568FALL-BLL.pdf) |
| IS62WV2568FALL-55T | 2Mb (256k x 8), 1.65-2.2V, 55ns, Low Voltage Ultra Low Power CMOS Static RAM, TSOP-I 32-pin | [Datasheet](http://www.issi.com/WW/pdf/62-65WV2568FALL-BLL.pdf) |
| IS62WV2568FBLL-45H | 2Mb (256k x 8), 2.2-3.6V, 45ns, Low Voltage Ultra Low Power CMOS Static RAM, sTSOP-I 32-pin | [Datasheet](http://www.issi.com/WW/pdf/62-65WV2568FALL-BLL.pdf) |
| IS62WV2568FBLL-45T | 2Mb (256k x 8), 2.2-3.6V, 45ns, Low Voltage Ultra Low Power CMOS Static RAM, TSOP-I 32-pin | [Datasheet](http://www.issi.com/WW/pdf/62-65WV2568FALL-BLL.pdf) |
| IS62WVS5128GBLL-xxNLx | 4Mb (512k x 8), 2.7-3.6V, Low Voltage, Fast Serial SRAM with SPI, SDI, and SQI interface, SOIC-8 | [Datasheet](https://www.issi.com/WW/pdf/IS62-65WVS5128GALL-BLL.pdf) |
| IS64C1024AL-15T | 1Mb (128k x 8), 5V, 15ns, High-Speed CMOS Static RAM, TSOP-I 32-pin | [Datasheet](http://www.issi.com/WW/pdf/62-65C1024AL.pdf) |
| IS65C1024AL-45Q | 1Mb (128k x 8), 5V, 45ns, Low Power CMOS Static RAM, SOP-32 | [Datasheet](http://www.issi.com/WW/pdf/62-65C1024AL.pdf) |
| IS65C1024AL-45T | 1Mb (128k x 8), 5V, 45ns, Low Power CMOS Static RAM, TSOP-I 32-pin | [Datasheet](http://www.issi.com/WW/pdf/62-65C1024AL.pdf) |
| IS65C256AL-xxT | 256kb (32k x 8), 5V, 25/45ns, Low Power CMOS Static RAM, TSOP-I 28-pin | [Datasheet](http://www.issi.com/WW/pdf/61C256AL.pdf) |
| IS65LV256AL-45T | 256kb (32k x 8), 3.3V, 45ns, Low Voltage CMOS Static RAM, TSOP-I 28-pin | [Datasheet](http://www.issi.com/WW/pdf/62-65LV256AL.pdf) |
| IS65WV10248EBLL-45CT | 8Mb (1M x 8), 2.2-3.6V, 45ns, Low Voltage Ulta Low Power CMOS Static RAM, TSOP-II 44-pin | [Datasheet](http://www.issi.com/WW/pdf/62-65WV10248EALL-BLL.pdf) |
| IS65WV10248EFALL-55CT | 8Mb (1M x 8), 1.65-2.2V, 55ns, Low Voltage Ulta Low Power CMOS Static RAM, TSOP-II 44-pin | [Datasheet](http://www.issi.com/WW/pdf/62-65WV10248EFALL-BLL.pdf) |
| IS65WV10248EFBLL-55CT | 8Mb (1M x 8), 2.2-3.6V, 55ns, Low Voltage Ulta Low Power CMOS Static RAM, TSOP-II 44-pin | [Datasheet](http://www.issi.com/WW/pdf/62-65WV10248EFALL-BLL.pdf) |
| IS65WV10248HBLL-55CT | 8Mb (1M x 8), 2.2-3.6V, 55ns, Low Voltage Ulta Low Power CMOS Static RAM, TSOP-II 44-pin | [Datasheet](http://www.issi.com/WW/pdf/62-65WV10248HALL-BLL.pdf) |
| IS65WV1288DBLL-45H | 1Mb (128k x 8), 2.3-3.6V, 45ns, Low Voltage Ultra Low Power CMOS Static RAM, sTSOP-I 32-pin | [Datasheet](http://www.issi.com/WW/pdf/62-65WV1288DALL-BLL.pdf) |
| IS65WV1288DBLL-45Q | 1Mb (128k x 8), 2.3-3.6V, 45ns, Low Voltage Ultra Low Power CMOS Static RAM, SOP-32 | [Datasheet](http://www.issi.com/WW/pdf/62-65WV1288DALL-BLL.pdf) |
| IS65WV1288DBLL-45T | 1Mb (128k x 8), 2.3-3.6V, 45ns, Low Voltage Ultra Low Power CMOS Static RAM, TSOP-I 32-pin | [Datasheet](http://www.issi.com/WW/pdf/62-65WV1288DALL-BLL.pdf) |
| IS65WV1288FBLL-55H | 1Mb (128k x 8), 2.2-3.6V, 55ns, Low Voltage Ultra Low Power CMOS Static RAM, sTSOP-I 32-pin | [Datasheet](http://www.issi.com/WW/pdf/62-65WV1288FALL-BLL.pdf) |
| IS65WV1288FBLL-55Q | 1Mb (128k x 8), 2.2-3.6V, 55ns, Low Voltage Ultra Low Power CMOS Static RAM, SOP-32 | [Datasheet](http://www.issi.com/WW/pdf/62-65WV1288FALL-BLL.pdf) |
| IS65WV1288FBLL-55T | 1Mb (128k x 8), 2.2-3.6V, 55ns, Low Voltage Ultra Low Power CMOS Static RAM, TSOP-I 32-pin | [Datasheet](http://www.issi.com/WW/pdf/62-65WV1288FALL-BLL.pdf) |
| IS65WV2568EBLL-55CT | 2Mb (256k x 8), 2.2-3.6V, 55ns, Low Voltage Ultra Low Power CMOS Static RAM, TSOP-I 32-pin | [Datasheet](http://www.issi.com/WW/pdf/62-65WV2568EALL-BLL.pdf) |
| IS65WV2568FBLL-55CT | 2Mb (256k x 8), 2.2-3.6V, 55ns, Low Voltage Ultra Low Power CMOS Static RAM, TSOP-I 32-pin | [Datasheet](http://www.issi.com/WW/pdf/62-65WV2568FALL-BLL.pdf) |
| IS66WVE4M16ExLL-xxBL | 64Mb (4M x 16) Async/Page PSRAM, TFBGA-48 | [Datasheet](http://www.issi.com/WW/pdf/66-67WVE4M16EALL-BLL-CLL.pdf) |
| JESD21-C_3.2.1.5_128k_x8_ROM_SOP-32 | 1 Mbit (128k x 8) JESD21-C 3.2.1.5 compatible ROM, SOP-32 | [Datasheet](https://www.jedec.org/category/technology-focus-area/memory-configurations-jesd21-c) |
| JESD21-C_3.2.1.5_1M_x8_ROM_SOP-32 | 8 Mbit (1M x 8) JESD21-C 3.2.1.5 compatible ROM, SOP-32 | [Datasheet](https://www.jedec.org/category/technology-focus-area/memory-configurations-jesd21-c) |
| JESD21-C_3.2.1.5_256k_x8_ROM_SOP-32 | 2 Mbit (256k x 8) JESD21-C 3.2.1.5 compatible ROM, SOP-32 | [Datasheet](https://www.jedec.org/category/technology-focus-area/memory-configurations-jesd21-c) |
| JESD21-C_3.2.1.5_512k_x8_ROM_SOP-32 | 4 Mbit (512k x 8) JESD21-C 3.2.1.5 compatible ROM, SOP-32 | [Datasheet](https://www.jedec.org/category/technology-focus-area/memory-configurations-jesd21-c) |
| JESD21-C_3.5.1.4_128k_x8_Flash_PLCC-32 | 1 Mbit (128k x 8) JESD21-C 3.5.1.14 Flash EEPROM, PLCC-32 | [Datasheet](https://www.jedec.org/category/technology-focus-area/memory-configurations-jesd21-c) |
| JESD21-C_3.5.1.4_256k_x8_Flash_PLCC-32 | 2 Mbit (256k x 8) JESD21-C 3.5.1.14 Flash EEPROM, PLCC-32 | [Datasheet](https://www.jedec.org/category/technology-focus-area/memory-configurations-jesd21-c) |
| JESD21-C_3.5.1.4_512k_x8_Flash_PLCC-32 | 4 Mbit (512k x 8) JESD21-C 3.5.1.14 Flash EEPROM, PLCC-32 | [Datasheet](https://www.jedec.org/category/technology-focus-area/memory-configurations-jesd21-c) |
| JESD21-C_3.7.5.4-16k_x8_SRAM_SOIC-28W | 128 kbit (16k x 8) JESD21-C 3.7.5.4 compatible static RAM, SOIC-28W | [Datasheet](https://www.jedec.org/category/technology-focus-area/memory-configurations-jesd21-c) |
| JESD21-C_3.7.5.4-2k_x8_SRAM_SOIC-28W | 16 kbit (2k x 8) JESD21-C 3.7.5.4 compatible static RAM, SOIC-28W | [Datasheet](https://www.jedec.org/category/technology-focus-area/memory-configurations-jesd21-c) |
| JESD21-C_3.7.5.4-32k_x8_SRAM_SOIC-28W | 256 kbit (32k x 8) JESD21-C 3.7.5.4 compatible static RAM, SOIC-28W | [Datasheet](https://www.jedec.org/category/technology-focus-area/memory-configurations-jesd21-c) |
| JESD21-C_3.7.5.4-4k_x8_SRAM_SOIC-28W | 32 kbit (4k x 8) JESD21-C 3.7.5.4 compatible static RAM, SOIC-28W | [Datasheet](https://www.jedec.org/category/technology-focus-area/memory-configurations-jesd21-c) |
| JESD21-C_3.7.5.4-8k_x8_SRAM_SOIC-28W | 64 kbit (8k x 8) JESD21-C 3.7.5.4 compatible static RAM, SOIC-28W | [Datasheet](https://www.jedec.org/category/technology-focus-area/memory-configurations-jesd21-c) |
| LC4032ZE-xxTN48 | 1.8 V In-System Programmable Ultra Low Power PLD, 32 macrocells, TQFP-48 | [Datasheet](http://www.latticesemi.com/view_document?document_id=29095) |
| LC4064ZE-xxTN100 | 1.8 V In-System Programmable Ultra Low Power PLD, 256 macrocells, TQFP-100 | [Datasheet](http://www.latticesemi.com/view_document?document_id=29095) |
| LC4064ZE-xxTN48 | 1.8 V In-System Programmable Ultra Low Power PLD, 64 macrocells, TQFP-48 | [Datasheet](http://www.latticesemi.com/view_document?document_id=29095) |
| LC4128ZE-xxTN100 | 1.8 V In-System Programmable Ultra Low Power PLD, 256 macrocells, TQFP-100 | [Datasheet](http://www.latticesemi.com/view_document?document_id=29095) |
| LC4128ZE-xxTN144 | 1.8 V In-System Programmable Ultra Low Power PLD, 128 macrocells, TQFP-144 | [Datasheet](http://www.latticesemi.com/view_document?document_id=29095) |
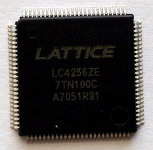
[picture p3: photos/LC4256ZE-xxTN100.jpg]
LC4256ZE-xxTN100
| LC4256ZE-xxTN100 <br>  | 1.8 V In-System Programmable Ultra Low Power PLD, 256 macrocells, TQFP-100 | [Datasheet](http://www.latticesemi.com/view_document?document_id=29095) |
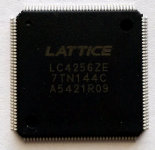
[picture p4: photos/LC4256ZE-xxTN144.jpg]
LC4256ZE-xxTN144
| LC4256ZE-xxTN144 <br>  | 1.8 V In-System Programmable Ultra Low Power PLD, 256 macrocells, TQFP-144 | [Datasheet](http://www.latticesemi.com/view_document?document_id=29095) |
| LCMXO2-1200xx-xSG32 | MachXO2 FPGA, 1200 LUT, QFN-32 | [Datasheet](https://www.latticesemi.com/view_document?document_id=38834) |
| LCMXO2-1200xx-xTG100 | MachXO2 FPGA, 1200 LUT, TQFP-100 | [Datasheet](https://www.latticesemi.com/view_document?document_id=38834) |
| LCMXO2-2000xx-xTG100 | MachXO2 FPGA, 2000 LUT, TQFP-100 | [Datasheet](https://www.latticesemi.com/view_document?document_id=38834) |
| LCMXO2-2000xx-xTG144 | MachXO2 FPGA, 2000 LUT, TQFP-144 | [Datasheet](https://www.latticesemi.com/view_document?document_id=38834) |
| LCMXO2-256xx-xSG32 | MachXO2 FPGA, 256 LUT, QFN-32 | [Datasheet](https://www.latticesemi.com/view_document?document_id=38834) |
| LCMXO2-256xx-xSG48 | MachXO2 FPGA, 256 LUT, QFN-48 | [Datasheet](https://www.latticesemi.com/view_document?document_id=38834) |
| LCMXO2-256xx-xTG100 | MachXO2 FPGA, 256 LUT, TQFP-100 | [Datasheet](https://www.latticesemi.com/view_document?document_id=38834) |
| LCMXO2-4000xx-xTG144 | MachXO2 FPGA, 4000 LUT, TQFP-144 | [Datasheet](https://www.latticesemi.com/view_document?document_id=38834) |
| LCMXO2-640xx-xSG48 | MachXO2 FPGA, 640 LUT, QFN-48 | [Datasheet](https://www.latticesemi.com/view_document?document_id=38834) |
| LCMXO2-640xx-xTG100 | MachXO2 FPGA, 640 LUT, TQFP-100 | [Datasheet](https://www.latticesemi.com/view_document?document_id=38834) |
| LCMXO2-7000xx-xTG144 | MachXO2 FPGA, 7000 LUT, TQFP-144 | [Datasheet](https://www.latticesemi.com/view_document?document_id=38834) |
| LM4818 | 350mW Audio Power Amplifier with Shutdown Mode, SOIC-8 | [Datasheet](http://www.ti.com/lit/ds/symlink/lm4818.pdf) |
| LM66100 | 5.5-V, 1.5-A 79-mΩ, Low IQ Ideal Diode With Input Polarity Protection, SOT-363 | [Datasheet](https://www.ti.com/lit/ds/symlink/lm66100.pdf) |
| LN1132PxxxM | 300mA Low Dropout CMOS Voltage Regulator, SOT-23-3 | [Datasheet](http://www.natlinear.com/uploadfiles/2014/LN/LN1132_E.pdf) |
| LT1965xDD | 1.1A, Adjustable, Low Noise, Low Dropout Linear Regulator, DFN-8 | [Datasheet](https://www.analog.com/media/en/technical-documentation/data-sheets/1965fb.pdf) |
| LT1965xDD-1.5 | 1.1A, 1.5V, Low Noise, Low Dropout Linear Regulator, DFN-8 | [Datasheet](https://www.analog.com/media/en/technical-documentation/data-sheets/1965fb.pdf) |
| LT1965xDD-1.8 | 1.1A, 1.8V, Low Noise, Low Dropout Linear Regulator, DFN-8 | [Datasheet](https://www.analog.com/media/en/technical-documentation/data-sheets/1965fb.pdf) |
| LT1965xDD-2.5 | 1.1A, 2.5V, Low Noise, Low Dropout Linear Regulator, DFN-8 | [Datasheet](https://www.analog.com/media/en/technical-documentation/data-sheets/1965fb.pdf) |
| LT1965xDD-3.3 | 1.1A, 3.3V, Low Noise, Low Dropout Linear Regulator, DFN-8 | [Datasheet](https://www.analog.com/media/en/technical-documentation/data-sheets/1965fb.pdf) |
| LT1965xMS8E | 1.1A, Adjustable, Low Noise, Low Dropout Linear Regulator, MSOP-8 | [Datasheet](https://www.analog.com/media/en/technical-documentation/data-sheets/1965fb.pdf) |
| LT1965xMS8E-1.5 | 1.1A, 1.5V, Low Noise, Low Dropout Linear Regulator, MSOP-8 | [Datasheet](https://www.analog.com/media/en/technical-documentation/data-sheets/1965fb.pdf) |
| LT1965xMS8E-1.8 | 1.1A, 1.8V, Low Noise, Low Dropout Linear Regulator, MSOP-8 | [Datasheet](https://www.analog.com/media/en/technical-documentation/data-sheets/1965fb.pdf) |
| LT1965xMS8E-2.5 | 1.1A, 2.5V, Low Noise, Low Dropout Linear Regulator, MSOP-8 | [Datasheet](https://www.analog.com/media/en/technical-documentation/data-sheets/1965fb.pdf) |
| LT1965xMS8E-3.3 | 1.1A, 3.3V, Low Noise, Low Dropout Linear Regulator, MSOP-8 | [Datasheet](https://www.analog.com/media/en/technical-documentation/data-sheets/1965fb.pdf) |
| LT1965xQ | 1.1A, Adjustable, Low Noise, Low Dropout Linear Regulator, TO-263 (DDPAK) | [Datasheet](https://www.analog.com/media/en/technical-documentation/data-sheets/1965fb.pdf) |
| LT1965xQ-1.5 | 1.1A, 1.5V, Low Noise, Low Dropout Linear Regulator, TO-263 (DDPAK) | [Datasheet](https://www.analog.com/media/en/technical-documentation/data-sheets/1965fb.pdf) |
| LT1965xQ-1.8 | 1.1A, 1.8V, Low Noise, Low Dropout Linear Regulator, TO-263 (DDPAK) | [Datasheet](https://www.analog.com/media/en/technical-documentation/data-sheets/1965fb.pdf) |
| LT1965xQ-2.5 | 1.1A, 2.5V, Low Noise, Low Dropout Linear Regulator, TO-263 (DDPAK) | [Datasheet](https://www.analog.com/media/en/technical-documentation/data-sheets/1965fb.pdf) |
| LT1965xQ-3.3 | 1.1A, 3.3V, Low Noise, Low Dropout Linear Regulator, TO-263 (DDPAK) | [Datasheet](https://www.analog.com/media/en/technical-documentation/data-sheets/1965fb.pdf) |
| LT1965xT | 1.1A, Adjustable, Low Noise, Low Dropout Linear Regulator, TO-220 | [Datasheet](https://www.analog.com/media/en/technical-documentation/data-sheets/1965fb.pdf) |
| LT1965xT-1.5 | 1.1A, 1.5V, Low Noise, Low Dropout Linear Regulator, TO-220 | [Datasheet](https://www.analog.com/media/en/technical-documentation/data-sheets/1965fb.pdf) |
| LT1965xT-1.8 | 1.1A, 1.8V, Low Noise, Low Dropout Linear Regulator, TO-220 | [Datasheet](https://www.analog.com/media/en/technical-documentation/data-sheets/1965fb.pdf) |
| LT1965xT-2.5 | 1.1A, 2.5V, Low Noise, Low Dropout Linear Regulator, TO-220 | [Datasheet](https://www.analog.com/media/en/technical-documentation/data-sheets/1965fb.pdf) |
| LT1965xT-3.3 | 1.1A, 3.3V, Low Noise, Low Dropout Linear Regulator, TO-220 | [Datasheet](https://www.analog.com/media/en/technical-documentation/data-sheets/1965fb.pdf) |
| LT8580xMS8E | Boost/SEPIC/Inverting DC/DC Converter with 1A, 65V Switch, Soft-Start and Synchronization, MSOP-8 | [Datasheet](https://www.analog.com/media/en/technical-documentation/data-sheets/lt8580.pdf) |
| LTC2943 | Multicell Battery Gas Gauge with Temperature, Voltage and Current Measurement | [Datasheet](https://www.analog.com/media/en/technical-documentation/data-sheets/2943fa.pdf) |
| LTC4011CFE | High Efficiency Standalone Nickel Battery Charger, TSSOP-20 | [Datasheet](https://www.analog.com/media/en/technical-documentation/data-sheets/4011fb.pdf) |
| MA3X720 | 40V 0.5A Small signal Schottky diode, SOT-23 | [Datasheet](https://industrial.panasonic.com/content/data/SC/ds/ds4/MA3X720_E_discon.pdf) |
| MA3X748 | 20V 0.5A Small signal Schottky diode, SOT-23 | [Datasheet](https://industrial.panasonic.com/content/data/SC/ds/ds4/MA3X748_E_discon.pdf) |
| MAX6029EUK21 | Ultra-Low-Power Precision Series Voltage Reference, 2.048V, SOT-23-5 | [Datasheet](https://datasheets.maximintegrated.com/en/ds/MAX6029.pdf) |
| MAX6029EUK25 | Ultra-Low-Power Precision Series Voltage Reference, 2.500V, SOT-23-5 | [Datasheet](https://datasheets.maximintegrated.com/en/ds/MAX6029.pdf) |
| MAX6029EUK30 | Ultra-Low-Power Precision Series Voltage Reference, 3.000V, SOT-23-5 | [Datasheet](https://datasheets.maximintegrated.com/en/ds/MAX6029.pdf) |
| MAX6029EUK33 | Ultra-Low-Power Precision Series Voltage Reference, 3.300V, SOT-23-5 | [Datasheet](https://datasheets.maximintegrated.com/en/ds/MAX6029.pdf) |
| MAX6029EUK41 | Ultra-Low-Power Precision Series Voltage Reference, 4.096V, SOT-23-5 | [Datasheet](https://datasheets.maximintegrated.com/en/ds/MAX6029.pdf) |
| MAX6029EUK50 | Ultra-Low-Power Precision Series Voltage Reference, 5.000V, SOT-23-5 | [Datasheet](https://datasheets.maximintegrated.com/en/ds/MAX6029.pdf) |
| MBC1 | Nintendo MBC1, SOIC-24 |  |
| MBC2 | Nintendo MBC2, SOIC-28 |  |
| MBC5 | Nintendo MBC5, TQFP-32 |  |
| MCP1811Ax-010LT | 1.0V, 150mA, Ultra-Low Quiescent Current LDO Regulator with Output Discharge, SOT-353 | [Datasheet](https://ww1.microchip.com/downloads/en/DeviceDoc/MCP1811A-11B-12A-12B-Family-Data-Sheet-DS20006088C.pdf) |
| MCP1811Ax-012LT | 1.2V, 150mA, Ultra-Low Quiescent Current LDO Regulator with Output Discharge, SOT-353 | [Datasheet](https://ww1.microchip.com/downloads/en/DeviceDoc/MCP1811A-11B-12A-12B-Family-Data-Sheet-DS20006088C.pdf) |
| MCP1811Ax-018LT | 1.8V, 150mA, Ultra-Low Quiescent Current LDO Regulator with Output Discharge, SOT-353 | [Datasheet](https://ww1.microchip.com/downloads/en/DeviceDoc/MCP1811A-11B-12A-12B-Family-Data-Sheet-DS20006088C.pdf) |
| MCP1811Ax-020LT | 2.0V, 150mA, Ultra-Low Quiescent Current LDO Regulator with Output Discharge, SOT-353 | [Datasheet](https://ww1.microchip.com/downloads/en/DeviceDoc/MCP1811A-11B-12A-12B-Family-Data-Sheet-DS20006088C.pdf) |
| MCP1811Ax-025LT | 2.5V, 150mA, Ultra-Low Quiescent Current LDO Regulator with Output Discharge, SOT-353 | [Datasheet](https://ww1.microchip.com/downloads/en/DeviceDoc/MCP1811A-11B-12A-12B-Family-Data-Sheet-DS20006088C.pdf) |
| MCP1811Ax-028LT | 2.8V, 150mA, Ultra-Low Quiescent Current LDO Regulator with Output Discharge, SOT-353 | [Datasheet](https://ww1.microchip.com/downloads/en/DeviceDoc/MCP1811A-11B-12A-12B-Family-Data-Sheet-DS20006088C.pdf) |
| MCP1811Ax-030LT | 3.0V, 150mA, Ultra-Low Quiescent Current LDO Regulator with Output Discharge, SOT-353 | [Datasheet](https://ww1.microchip.com/downloads/en/DeviceDoc/MCP1811A-11B-12A-12B-Family-Data-Sheet-DS20006088C.pdf) |
| MCP1811Ax-033LT | 3.3V, 150mA, Ultra-Low Quiescent Current LDO Regulator with Output Discharge, SOT-353 | [Datasheet](https://ww1.microchip.com/downloads/en/DeviceDoc/MCP1811A-11B-12A-12B-Family-Data-Sheet-DS20006088C.pdf) |
| MCP1811Ax-040LT | 4.0V, 150mA, Ultra-Low Quiescent Current LDO Regulator with Output Discharge, SOT-353 | [Datasheet](https://ww1.microchip.com/downloads/en/DeviceDoc/MCP1811A-11B-12A-12B-Family-Data-Sheet-DS20006088C.pdf) |
| MCP1811Bx-010LT | 1.0V, 150mA, Ultra-Low Quiescent Current LDO Regulator, SOT-353 | [Datasheet](https://ww1.microchip.com/downloads/en/DeviceDoc/MCP1811A-11B-12A-12B-Family-Data-Sheet-DS20006088C.pdf) |
| MCP1811Bx-012LT | 1.2V, 150mA, Ultra-Low Quiescent Current LDO Regulator, SOT-353 | [Datasheet](https://ww1.microchip.com/downloads/en/DeviceDoc/MCP1811A-11B-12A-12B-Family-Data-Sheet-DS20006088C.pdf) |
| MCP1811Bx-018LT | 1.8V, 150mA, Ultra-Low Quiescent Current LDO Regulator, SOT-353 | [Datasheet](https://ww1.microchip.com/downloads/en/DeviceDoc/MCP1811A-11B-12A-12B-Family-Data-Sheet-DS20006088C.pdf) |
| MCP1811Bx-020LT | 2.0V, 150mA, Ultra-Low Quiescent Current LDO Regulator, SOT-353 | [Datasheet](https://ww1.microchip.com/downloads/en/DeviceDoc/MCP1811A-11B-12A-12B-Family-Data-Sheet-DS20006088C.pdf) |
| MCP1811Bx-025LT | 2.5V, 150mA, Ultra-Low Quiescent Current LDO Regulator, SOT-353 | [Datasheet](https://ww1.microchip.com/downloads/en/DeviceDoc/MCP1811A-11B-12A-12B-Family-Data-Sheet-DS20006088C.pdf) |
| MCP1811Bx-028LT | 2.8V, 150mA, Ultra-Low Quiescent Current LDO Regulator, SOT-353 | [Datasheet](https://ww1.microchip.com/downloads/en/DeviceDoc/MCP1811A-11B-12A-12B-Family-Data-Sheet-DS20006088C.pdf) |
| MCP1811Bx-030LT | 3.0V, 150mA, Ultra-Low Quiescent Current LDO Regulator, SOT-353 | [Datasheet](https://ww1.microchip.com/downloads/en/DeviceDoc/MCP1811A-11B-12A-12B-Family-Data-Sheet-DS20006088C.pdf) |
| MCP1811Bx-033LT | 3.3V, 150mA, Ultra-Low Quiescent Current LDO Regulator, SOT-353 | [Datasheet](https://ww1.microchip.com/downloads/en/DeviceDoc/MCP1811A-11B-12A-12B-Family-Data-Sheet-DS20006088C.pdf) |
| MCP1811Bx-040LT | 4.0V, 150mA, Ultra-Low Quiescent Current LDO Regulator, SOT-353 | [Datasheet](https://ww1.microchip.com/downloads/en/DeviceDoc/MCP1811A-11B-12A-12B-Family-Data-Sheet-DS20006088C.pdf) |
| MCP1812Ax-010LT | 1.0V, 300mA, Ultra-Low Quiescent Current LDO Regulator with Output Discharge, SOT-353 | [Datasheet](https://ww1.microchip.com/downloads/en/DeviceDoc/MCP1811A-11B-12A-12B-Family-Data-Sheet-DS20006088C.pdf) |
| MCP1812Ax-012LT | 1.2V, 300mA, Ultra-Low Quiescent Current LDO Regulator with Output Discharge, SOT-353 | [Datasheet](https://ww1.microchip.com/downloads/en/DeviceDoc/MCP1811A-11B-12A-12B-Family-Data-Sheet-DS20006088C.pdf) |
| MCP1812Ax-018LT | 1.8V, 300mA, Ultra-Low Quiescent Current LDO Regulator with Output Discharge, SOT-353 | [Datasheet](https://ww1.microchip.com/downloads/en/DeviceDoc/MCP1811A-11B-12A-12B-Family-Data-Sheet-DS20006088C.pdf) |
| MCP1812Ax-020LT | 2.0V, 300mA, Ultra-Low Quiescent Current LDO Regulator with Output Discharge, SOT-353 | [Datasheet](https://ww1.microchip.com/downloads/en/DeviceDoc/MCP1811A-11B-12A-12B-Family-Data-Sheet-DS20006088C.pdf) |
| MCP1812Ax-025LT | 2.5V, 300mA, Ultra-Low Quiescent Current LDO Regulator with Output Discharge, SOT-353 | [Datasheet](https://ww1.microchip.com/downloads/en/DeviceDoc/MCP1811A-11B-12A-12B-Family-Data-Sheet-DS20006088C.pdf) |
| MCP1812Ax-028LT | 2.8V, 300mA, Ultra-Low Quiescent Current LDO Regulator with Output Discharge, SOT-353 | [Datasheet](https://ww1.microchip.com/downloads/en/DeviceDoc/MCP1811A-11B-12A-12B-Family-Data-Sheet-DS20006088C.pdf) |
| MCP1812Ax-030LT | 3.0V, 300mA, Ultra-Low Quiescent Current LDO Regulator with Output Discharge, SOT-353 | [Datasheet](https://ww1.microchip.com/downloads/en/DeviceDoc/MCP1811A-11B-12A-12B-Family-Data-Sheet-DS20006088C.pdf) |
| MCP1812Ax-033LT | 3.3V, 300mA, Ultra-Low Quiescent Current LDO Regulator with Output Discharge, SOT-353 | [Datasheet](https://ww1.microchip.com/downloads/en/DeviceDoc/MCP1811A-11B-12A-12B-Family-Data-Sheet-DS20006088C.pdf) |
| MCP1812Ax-040LT | 4.0V, 300mA, Ultra-Low Quiescent Current LDO Regulator with Output Discharge, SOT-353 | [Datasheet](https://ww1.microchip.com/downloads/en/DeviceDoc/MCP1811A-11B-12A-12B-Family-Data-Sheet-DS20006088C.pdf) |
| MCP1812Bx-010LT | 1.0V, 300mA, Ultra-Low Quiescent Current LDO Regulator, SOT-353 | [Datasheet](https://ww1.microchip.com/downloads/en/DeviceDoc/MCP1811A-11B-12A-12B-Family-Data-Sheet-DS20006088C.pdf) |
| MCP1812Bx-012LT | 1.2V, 300mA, Ultra-Low Quiescent Current LDO Regulator, SOT-353 | [Datasheet](https://ww1.microchip.com/downloads/en/DeviceDoc/MCP1811A-11B-12A-12B-Family-Data-Sheet-DS20006088C.pdf) |
| MCP1812Bx-018LT | 1.8V, 300mA, Ultra-Low Quiescent Current LDO Regulator, SOT-353 | [Datasheet](https://ww1.microchip.com/downloads/en/DeviceDoc/MCP1811A-11B-12A-12B-Family-Data-Sheet-DS20006088C.pdf) |
| MCP1812Bx-020LT | 2.0V, 300mA, Ultra-Low Quiescent Current LDO Regulator, SOT-353 | [Datasheet](https://ww1.microchip.com/downloads/en/DeviceDoc/MCP1811A-11B-12A-12B-Family-Data-Sheet-DS20006088C.pdf) |
| MCP1812Bx-025LT | 2.5V, 300mA, Ultra-Low Quiescent Current LDO Regulator, SOT-353 | [Datasheet](https://ww1.microchip.com/downloads/en/DeviceDoc/MCP1811A-11B-12A-12B-Family-Data-Sheet-DS20006088C.pdf) |
| MCP1812Bx-028LT | 2.8V, 300mA, Ultra-Low Quiescent Current LDO Regulator, SOT-353 | [Datasheet](https://ww1.microchip.com/downloads/en/DeviceDoc/MCP1811A-11B-12A-12B-Family-Data-Sheet-DS20006088C.pdf) |
| MCP1812Bx-030LT | 3.0V, 300mA, Ultra-Low Quiescent Current LDO Regulator, SOT-353 | [Datasheet](https://ww1.microchip.com/downloads/en/DeviceDoc/MCP1811A-11B-12A-12B-Family-Data-Sheet-DS20006088C.pdf) |
| MCP1812Bx-033LT | 3.3V, 300mA, Ultra-Low Quiescent Current LDO Regulator, SOT-353 | [Datasheet](https://ww1.microchip.com/downloads/en/DeviceDoc/MCP1811A-11B-12A-12B-Family-Data-Sheet-DS20006088C.pdf) |
| MCP1812Bx-040LT | 4.0V, 300mA, Ultra-Low Quiescent Current LDO Regulator, SOT-353 | [Datasheet](https://ww1.microchip.com/downloads/en/DeviceDoc/MCP1811A-11B-12A-12B-Family-Data-Sheet-DS20006088C.pdf) |
| MCP6411T-xLT | Single 1-MHz, Rail-to-Rail Input/Output, Operational Amplifier with EMI filtering, SC-70-5 | [Datasheet](http://ww1.microchip.com/downloads/en/DeviceDoc/20005791B.pdf) |
| MCP6411T-xOT | Single 1-MHz, Rail-to-Rail Input/Output, Operational Amplifier with EMI filtering, SOT-23-5 | [Datasheet](http://ww1.microchip.com/downloads/en/DeviceDoc/20005791B.pdf) |
| MIC2005A-1YM6 | Fixed current limiting power distribution switch, SOT-23-6 | [Datasheet](http://ww1.microchip.com/downloads/en/DeviceDoc/mic20xx.pdf) |
| MIC2005A-2YM6 | Fixed current limiting power distribution switch, SOT-23-6 | [Datasheet](http://ww1.microchip.com/downloads/en/DeviceDoc/mic20xx.pdf) |
| MIC2091-2YM5 | Current limiting power distribution switch, 100 mA, latch-off, SOT-23-5 | [Datasheet](https://ww1.microchip.com/downloads/aemDocuments/documents/APID/ProductDocuments/DataSheets/MIC2090-1-Current-Limiting-Power-Distribution-Switches-DS20006611A.pdf) |
| MIC23158 | 3 MHz PWM Dual 2A Buck Regulator with HyperLight Load and Power Good, QFN-20 | [Datasheet](http://ww1.microchip.com/downloads/en/DeviceDoc/MIC23158-9-3MHz-PWM-Dual-2A-Buck-Regulator-with-HyperLight-Load-and-Power-Good-DS20006020A.pdf) |
| MIC23159 | 3 MHz PWM Dual 2A Buck Regulator with HyperLight Load and Power Good, Auto-Discharge, QFN-20 | [Datasheet](http://ww1.microchip.com/downloads/en/DeviceDoc/MIC23158-9-3MHz-PWM-Dual-2A-Buck-Regulator-with-HyperLight-Load-and-Power-Good-DS20006020A.pdf) |
| MIC23250-AAYMT | 4 MHz Dual 400 mA Synchronous Buck Regulator with Hyperlight Load™, DFN-12 | [Datasheet](http://ww1.microchip.com/downloads/en/DeviceDoc/mic23250.pdf) |
| MIC5370 | High-Performance Dual 150mA LDO, MLF-6 | [Datasheet](http://ww1.microchip.com/downloads/en/DeviceDoc/mic5370.pdf) |
| MIC920xC5 | 80 MHz Low-Power Op Amp, SC-70-5 | [Datasheet](http://ww1.microchip.com/downloads/en/DeviceDoc/mic920.pdf) |
| MM1134 | System Reset (with battery back-up), SOP-8 | [Datasheet](https://www.mitsumi.co.jp/latest/Catalog/ic/common/stop/micro_mm_1134_e.pdf) |
| MM1581 | Lithium-Ion Battery Charge Control, TSSOP-16 | [Datasheet](https://www.mitsumi.co.jp/latest/Catalog/ic/common/stop/battery_mm_1581_e.pdf) |
| MP2122GJ | 6V, 2A, Low Quiescent Current Dual, Sync Buck Regulator, TSOT23-8 | [Datasheet](https://www.monolithicpower.com/en/documentview/productdocument/index/version/2/document_type/Datasheet/lang/en/sku/MP2122/document_id/413) |
| MP2155GQ | High Efficiency Single Inductor Buck-Boost Converter with 2.2A Switches, DFN-10 | [Datasheet](https://www.monolithicpower.com/en/documentview/productdocument/index/version/2/document_type/Datasheet/lang/en/sku/MP2155/document_id/1760/) |
| MT48LC16M16A2F4 | 256Mb (16M x 16) Synchronous DRAM, VFBGA 54-ball | [Datasheet](https://www.micron.com/-/media/client/global/documents/products/data-sheet/dram/256mb_sdr.pdf) |
| MT9700 | 80mΩ, Adjustable Fast Response Current-Limited Power-Distribution Switch, SOT-23-5 | [Datasheet](https://datasheet.lcsc.com/szlcsc/XI-AN-Aerosemi-Tech-MT9700_C89855.pdf) |
| MX25L12805D | 128Mb (128M x 1) CMOS SPI Serial Flash, SOP-16 | [Datasheet](https://datasheet.octopart.com/MX25L12805DMI-20G-Macronix-datasheet-8332919.pdf) |
| MX29F200CxT | 2 Mb (256k x 8 / 128k x 16) Single Voltage 5V Only Flash Memory, TSOP-I 48-pin | [Datasheet](http://www.macronix.com/Lists/Datasheet/Attachments/7286/MX29F200C%20T-B,%205V,%202Mb,%20v2.1.pdf) |
| MX29F400CxT | 4 Mb (512k x 8 / 256k x 16) Single Voltage 5V Only Flash Memory, TSOP-I 48-pin | [Datasheet](http://www.macronix.com/Lists/Datasheet/Attachments/7285/MX29F400C%20T-B,%205V,%204Mb,%20v2.3.pdf) |
| MX29F800CxT | 8 Mb (1M x 8 / 512k x 16) Single Voltage 5V Only Flash Memory, TSOP-I 48-pin | [Datasheet](http://www.macronix.com/Lists/Datasheet/Attachments/7284/MX29F800C%20T-B,%205V,%208Mb,%20v1.3.pdf) |
| MX29GL320ExT | 32 Mb (4M x 8 / 2M x 16) Single Voltage 3V Only Flash Memory, TSOP-I 48-pin | [Datasheet](http://www.macronix.com/Lists/Datasheet/Attachments/7280/MX29GL320E%20T-B,%203V,%2032Mb,%20v1.5.pdf) |
| MX29GL640ExT | 64 Mb (8M x 8 / 4M x 16) Single Voltage 3V Only Flash Memory, TSOP-I 48-pin | [Datasheet](http://www.macronix.com/Lists/Datasheet/Attachments/7288/MX29GL640E%20T-B,%203V,%2064Mb,%20v1.9.pdf) |
| MX29LV160DxT | 16 Mb (2M x 8 / 1M x 16) Single Voltage 3V Only Flash Memory, TSOP-I 48-pin | [Datasheet](http://www.macronix.com/Lists/Datasheet/Attachments/7263/MX29LV160D%20T-B,%203V,%2016Mb,%20v1.2.pdf) |
| MX29LV161DxT | 16 Mb (1M x 16) Single Voltage 3V Only Flash Memory, TSOP-I 48-pin | [Datasheet](http://www.macronix.com/Lists/Datasheet/Attachments/7263/MX29LV160D%20T-B,%203V,%2016Mb,%20v1.2.pdf) |
| MX29LV320ExT | 32 Mb (4M x 8 / 2M x 16) Single Voltage 3V Only Flash Memory, TSOP-I 48-pin | [Datasheet](http://www.macronix.com/Lists/Datasheet/Attachments/7274/MX29LV320E%20T-B,%203V,%2032Mb,%20v1.3.pdf) |
| MX29LV400CxT | 4 Mb (512k x 8 / 256k x 16) Single Voltage 3V Only Flash Memory, TSOP-I 48-pin | [Datasheet](http://www.macronix.com/Lists/Datasheet/Attachments/7257/MX29LV400C%20T-B,%203V,%204Mb,%20v2.6.pdf) |
| MX29LV640ExT | 64 Mb (8M x 8 / 4M x 16) Single Voltage 3V Only Flash Memory, TSOP-I 48-pin | [Datasheet](http://www.macronix.com/Lists/Datasheet/Attachments/7255/MX29LV640E%20T-B,%203V,%2064Mb,%20v1.7.pdf) |
| MX29LV800CxT | 8 Mb (1M x 8 / 512k x 16) Single Voltage 3V Only Flash Memory, TSOP-I 48-pin | [Datasheet](http://www.macronix.com/Lists/Datasheet/Attachments/7258/MX29LV800C%20T-B,%203V,%208Mb,%20v2.6.pdf) |
| MX29SL402CxT | 4 Mb (512k x 8 / 256k x 16) Single Voltage 1.8V Only Flash Memory, TSOP-I 48-pin | [Datasheet](http://www.macronix.com/Lists/Datasheet/Attachments/7237/MX29SL402C%20T-B,%201.8V,%204Mb,%20v1.0.pdf) |
| MX29SL800CxT | 8 Mb (1M x 8 / 512k x 16) Single Voltage 1.8V Only Flash Memory, TSOP-I 48-pin | [Datasheet](http://www.macronix.com/Lists/Datasheet/Attachments/7235/MX29SL802C%20T-B,%201.8V,%208Mb,%20v2.0.pdf) |
| NCP164ASN330T1G | 3.3 V, 300 mA, LDO Regulator, Low Dropout Voltage, Ultra Low Noise, High PSRR with Power Good, TSOT-23-5 | [Datasheet](https://www.onsemi.com/download/data-sheet/pdf/ncp164-d.pdf) |
| NCP605MN15 | 1.5V, 500mA, Low IGND, CMOS LDO Regulator with Enhanced ESD Protection, DFN-6 | [Datasheet](https://www.onsemi.com/pub/Collateral/NCP605-D.PDF) |
| NCP605MN18 | 1.8V, 500mA, Low IGND, CMOS LDO Regulator with Enhanced ESD Protection, DFN-6 | [Datasheet](https://www.onsemi.com/pub/Collateral/NCP605-D.PDF) |
| NCP605MN25 | 2.5V, 500mA, Low IGND, CMOS LDO Regulator with Enhanced ESD Protection, DFN-6 | [Datasheet](https://www.onsemi.com/pub/Collateral/NCP605-D.PDF) |
| NCP605MN28 | 2.8V, 500mA, Low IGND, CMOS LDO Regulator with Enhanced ESD Protection, DFN-6 | [Datasheet](https://www.onsemi.com/pub/Collateral/NCP605-D.PDF) |
| NCP605MN30 | 3.0V, 500mA, Low IGND, CMOS LDO Regulator with Enhanced ESD Protection, DFN-6 | [Datasheet](https://www.onsemi.com/pub/Collateral/NCP605-D.PDF) |
| NCP605MN33 | 3.3V, 500mA, Low IGND, CMOS LDO Regulator with Enhanced ESD Protection, DFN-6 | [Datasheet](https://www.onsemi.com/pub/Collateral/NCP605-D.PDF) |
| NCP605MN50 | 5.0V, 500mA, Low IGND, CMOS LDO Regulator with Enhanced ESD Protection, DFN-6 | [Datasheet](https://www.onsemi.com/pub/Collateral/NCP605-D.PDF) |
| NCP605MNADJ | Adjustable, 500mA, Low IGND, CMOS LDO Regulator with Enhanced ESD Protection, DFN-6 | [Datasheet](https://www.onsemi.com/pub/Collateral/NCP605-D.PDF) |
| NCP606MN15 | 1.5V, 500mA, Low IGND, CMOS LDO Regulator with Enable and with Enhanced ESD Protection, DFN-6 | [Datasheet](https://www.onsemi.com/pub/Collateral/NCP605-D.PDF) |
| NCP606MN18 | 1.8V, 500mA, Low IGND, CMOS LDO Regulator with Enable and with Enhanced ESD Protection, DFN-6 | [Datasheet](https://www.onsemi.com/pub/Collateral/NCP605-D.PDF) |
| NCP606MN25 | 2.5V, 500mA, Low IGND, CMOS LDO Regulator with Enable and with Enhanced ESD Protection, DFN-6 | [Datasheet](https://www.onsemi.com/pub/Collateral/NCP605-D.PDF) |
| NCP606MN28 | 2.8V, 500mA, Low IGND, CMOS LDO Regulator with Enable and with Enhanced ESD Protection, DFN-6 | [Datasheet](https://www.onsemi.com/pub/Collateral/NCP605-D.PDF) |
| NCP606MN30 | 3.0V, 500mA, Low IGND, CMOS LDO Regulator with Enable and with Enhanced ESD Protection, DFN-6 | [Datasheet](https://www.onsemi.com/pub/Collateral/NCP605-D.PDF) |
| NCP606MN33 | 3.3V, 500mA, Low IGND, CMOS LDO Regulator with Enable and with Enhanced ESD Protection, DFN-6 | [Datasheet](https://www.onsemi.com/pub/Collateral/NCP605-D.PDF) |
| NCP606MN50 | 5.0V, 500mA, Low IGND, CMOS LDO Regulator with Enable and with Enhanced ESD Protection, DFN-6 | [Datasheet](https://www.onsemi.com/pub/Collateral/NCP605-D.PDF) |
| NCP606MNADJ | Adjustable, 500mA, Low IGND, CMOS LDO Regulator with Enable and with Enhanced ESD Protection, DFN-6 | [Datasheet](https://www.onsemi.com/pub/Collateral/NCP605-D.PDF) |
| NCV8535ML180R2G | 1.8V, 500mA, Voltage Regulator, Ultra High Accuracy, Low Iq, Low Dropout, Enable, DFN-10 | [Datasheet](https://www.onsemi.com/pdf/datasheet/ncv8535-d.pdf) |
| NCV8535ML250R2G | 2.5V, 500mA, Voltage Regulator, Ultra High Accuracy, Low Iq, Low Dropout, Enable, DFN-10 | [Datasheet](https://www.onsemi.com/pdf/datasheet/ncv8535-d.pdf) |
| NCV8535ML330R2G | 3.3V, 500mA, Voltage Regulator, Ultra High Accuracy, Low Iq, Low Dropout, Enable, DFN-10 | [Datasheet](https://www.onsemi.com/pdf/datasheet/ncv8535-d.pdf) |
| NCV8535MLADJR2G | Adjustable, 500mA, Voltage Regulator, Ultra High Accuracy, Low Iq, Low Dropout, Enable, DFN-10 | [Datasheet](https://www.onsemi.com/pdf/datasheet/ncv8535-d.pdf) |
| NCV8535MN150R2G | 1.5V, 500mA, Voltage Regulator, Ultra High Accuracy, Low Iq, Low Dropout, Enable, DFN-10 | [Datasheet](https://www.onsemi.com/pdf/datasheet/ncv8535-d.pdf) |
| NCV8535MN180R2G | 1.8V, 500mA, Voltage Regulator, Ultra High Accuracy, Low Iq, Low Dropout, Enable, DFN-10 | [Datasheet](https://www.onsemi.com/pdf/datasheet/ncv8535-d.pdf) |
| NCV8535MN190R2G | 1.9V, 500mA, Voltage Regulator, Ultra High Accuracy, Low Iq, Low Dropout, Enable, DFN-10 | [Datasheet](https://www.onsemi.com/pdf/datasheet/ncv8535-d.pdf) |
| NCV8535MN250R2G | 2.5V, 500mA, Voltage Regulator, Ultra High Accuracy, Low Iq, Low Dropout, Enable, DFN-10 | [Datasheet](https://www.onsemi.com/pdf/datasheet/ncv8535-d.pdf) |
| NCV8535MN280R2G | 2.8V, 500mA, Voltage Regulator, Ultra High Accuracy, Low Iq, Low Dropout, Enable, DFN-10 | [Datasheet](https://www.onsemi.com/pdf/datasheet/ncv8535-d.pdf) |
| NCV8535MN285R2G | 2.85V, 500mA, Voltage Regulator, Ultra High Accuracy, Low Iq, Low Dropout, Enable, DFN-10 | [Datasheet](https://www.onsemi.com/pdf/datasheet/ncv8535-d.pdf) |
| NCV8535MN300R2G | 3.0V, 500mA, Voltage Regulator, Ultra High Accuracy, Low Iq, Low Dropout, Enable, DFN-10 | [Datasheet](https://www.onsemi.com/pdf/datasheet/ncv8535-d.pdf) |
| NCV8535MN330R2G | 3.3V, 500mA, Voltage Regulator, Ultra High Accuracy, Low Iq, Low Dropout, Enable, DFN-10 | [Datasheet](https://www.onsemi.com/pdf/datasheet/ncv8535-d.pdf) |
| NCV8535MN350R2G | 3.5V, 500mA, Voltage Regulator, Ultra High Accuracy, Low Iq, Low Dropout, Enable, DFN-10 | [Datasheet](https://www.onsemi.com/pdf/datasheet/ncv8535-d.pdf) |
| NCV8535MN500R2G | 5.0V, 500mA, Voltage Regulator, Ultra High Accuracy, Low Iq, Low Dropout, Enable, DFN-10 | [Datasheet](https://www.onsemi.com/pdf/datasheet/ncv8535-d.pdf) |
| NCV8535MNADJR2G | Adjustable, 500mA, Voltage Regulator, Ultra High Accuracy, Low Iq, Low Dropout, Enable, DFN-10 | [Datasheet](https://www.onsemi.com/pdf/datasheet/ncv8535-d.pdf) |
| NSR0530H | 30V 500mA Schottky diode, SOD-323 | [Datasheet](http://www.onsemi.com/pub/Collateral/NSR0530H-D.PDF) |
| NT5DS32M16CS | 512Mb (32M x 16) DDR SDRAM, TSOP-II 66-pin | [Datasheet](https://elinux.org/images/e/e0/Nt5d32m16cs-5t.pdf) |
| OPA1632D | High-Performance, Fully-Differential Audio Operational Amplifier, SOIC-8 | [Datasheet](http://www.ti.com/lit/ds/sbos286c/sbos286c.pdf) |
| OPA210IDBV | Single 18MHz, Rail-to-Rail Output, 2.2-nV/√Hz Precision, Low-Power, 36-V Operational Amplifier, SOT-23-5 | [Datasheet](https://www.ti.com/lit/ds/symlink/opa210.pdf) |
| OPA2210ID | Dual 18MHz, Rail-to-Rail Output, 2.2-nV/√Hz Precision, Low-Power, 36-V Operational Amplifier, SOIC-8 | [Datasheet](https://www.ti.com/lit/ds/symlink/opa210.pdf) |
| OPA350UA | High-Speed, Single-Supply, Rail-to-Rail Operational Amplifiers MicroAmplifier Series, SOIC-8 | [Datasheet](http://www.ti.com/lit/ds/symlink/opa4350.pdf) |
| PAM2308BYMAA | Dual high-efficiency PWM step-down DC-DC converter, DFN-10 | [Datasheet](https://www.diodes.com/assets/Datasheets/products_inactive_data/PAM2308.pdf) |
| PCA9517ADP | Level translating I2C-bus repeater, TSSOP-8 | [Datasheet](https://www.nxp.com/docs/en/data-sheet/PCA9517.pdf) |
| PCF85063BTL | SPI Real-Time Clock Calendar w/ Alarm, DFN-10 | [Datasheet](https://www.nxp.com/docs/en/data-sheet/PCF85063BTL.pdf) |
| PIC18F45K50-IP | 32K Flash, 2K RAM, 256B EEPROM, Microchip PIC18F series enhanced flash microcontroller with USB, DIP-40 | [Datasheet](http://ww1.microchip.com/downloads/en/DeviceDoc/30000684B.pdf) |
| PIC18LF45K50-IP | 32K Flash, 2K RAM, 256B EEPROM, Microchip PIC18F series enhanced flash microcontroller with USB, DIP-40 | [Datasheet](http://ww1.microchip.com/downloads/en/DeviceDoc/30000684B.pdf) |
| PST9135N | System Reset, SOT-23-5 | [Datasheet](https://www.semiee.com/file/EOL2/Mitsumi-PST9119N.pdf) |
| RN4986 | Dual Digital NPN+PNP Transistor, 4k7/47k, SC-70-6 | [Datasheet](https://toshiba.semicon-storage.com/info/docget.jsp?did=18983&prodName=RN4986) |
| RS2057XC6 | 4.5Ohm Low Voltage SPDT Analog Switch, SC-70-6 | [Datasheet](http://en.run-ic.com/action/download?file=219) |
| RS2057XH | 4.5Ohm Low Voltage SPDT Analog Switch, SOT-23-6 | [Datasheet](http://en.run-ic.com/action/download?file=219) |
| RS2103XC6 | 0.6Ohm Low Voltage SPDT Analog Switch, SC-70-6 | [Datasheet](http://en.run-ic.com/action/download?file=217) |
| RS2103XH | 0.6Ohm Low Voltage SPDT Analog Switch, SOT-23-6 | [Datasheet](http://en.run-ic.com/action/download?file=217) |
| RS2257XC6 | 0.6Ohm Low Voltage SPDT Analog Switch, SC-70-6 | [Datasheet](http://en.run-ic.com/action/download?file=224) |
| RS2257XH | 0.6Ohm Low Voltage SPDT Analog Switch, SOT-23-6 | [Datasheet](http://en.run-ic.com/action/download?file=224) |
| RS8751BXF | Single 250MHz, Rail-to-Rail Output CMOS Operational Amplifier, SOT-23-5 | [Datasheet](https://datasheet.lcsc.com/szlcsc/Jiangsu-RUNIC-Tech-RS8752XQ_C255422.pdf) |
| RS8751XF | Single 250MHz, Rail-to-Rail Output CMOS Operational Amplifier, SOT-23-5 | [Datasheet](https://datasheet.lcsc.com/szlcsc/Jiangsu-RUNIC-Tech-RS8752XQ_C255422.pdf) |
| RS8752XK | Dual 250MHz, Rail-to-Rail Output CMOS Operational Amplifier, SOIC-8 | [Datasheet](https://datasheet.lcsc.com/szlcsc/Jiangsu-RUNIC-Tech-RS8752XQ_C255422.pdf) |
| RS8752XM | Dual 250MHz, Rail-to-Rail Output CMOS Operational Amplifier, MSOP-8 | [Datasheet](https://datasheet.lcsc.com/szlcsc/Jiangsu-RUNIC-Tech-RS8752XQ_C255422.pdf) |
| RS8752XQ | Dual 250MHz, Rail-to-Rail Output CMOS Operational Amplifier, TSSOP-8 | [Datasheet](https://datasheet.lcsc.com/szlcsc/Jiangsu-RUNIC-Tech-RS8752XQ_C255422.pdf) |
| RT7295C | 3.5A, 18V, 500kHz ACOT Synchronous Step-Down Converter, TSOT-23-6 | [Datasheet](https://www.richtek.com/assets/product_file/RT7295C/DS7295C-04.pdf) |
| R_Potentiometer_GameBoy_Contrast_DMG | LCD contrast potentiometer, original Game Boy (DMG) |  |
| R_Potentiometer_GameBoy_Contrast_MGB | LCD contrast potentiometer, Game Boy Pocket (MGB) |  |
| R_Potentiometer_GameBoy_Contrast_MGL | LCD contrast potentiometer, Game Boy Light (MGL) |  |
| R_Potentiometer_GameBoy_Volume_DMG | Audio volume potentiometer, original Game Boy (DMG) |  |
| R_Potentiometer_GameBoy_Volume_MGB | Audio volume potentiometer, Game Boy Pocket (MGB) |  |
| R_Potentiometer_GameBoy_Volume_MGL | Audio volume potentiometer, Game Boy Light (MGL) |  |
| S-8327B50MC-ESE | Step-up regulator, 5.0V |  |
| SE3608 | 2A/1.2MHz Output Current, Boost Converter, SOT-23-6 | [Datasheet](http://www.seawardinc.com.cn/webeditor/uploadfile/20200907180455365.pdf) |
| SE8117TA-HF-1.5V | 1.5V, 1A, Positive Voltage Regulator, SOT-223 | [Datasheet](http://www.seawardinc.com.cn/webeditor/uploadfile/20200423183538362.pdf) |
| SE8117TA-HF-1.8V | 1.8V, 1A, Positive Voltage Regulator, SOT-223 | [Datasheet](http://www.seawardinc.com.cn/webeditor/uploadfile/20200423183538362.pdf) |
| SE8117TA-HF-2.5V | 2.5V, 1A, Positive Voltage Regulator, SOT-223 | [Datasheet](http://www.seawardinc.com.cn/webeditor/uploadfile/20200423183538362.pdf) |
| SE8117TA-HF-3.3V | 3.3V, 1A, Positive Voltage Regulator, SOT-223 | [Datasheet](http://www.seawardinc.com.cn/webeditor/uploadfile/20200423183538362.pdf) |
| SE8117TA-HF-5.0V | 5.0V, 1A, Positive Voltage Regulator, SOT-223 | [Datasheet](http://www.seawardinc.com.cn/webeditor/uploadfile/20200423183538362.pdf) |
| SE8117TA-HF-ADJ | Adjustable, 1A, Positive Voltage Regulator, SOT-223 | [Datasheet](http://www.seawardinc.com.cn/webeditor/uploadfile/20200423183538362.pdf) |
| SN74CB3T16210DGG | 20-bit FET bus switch, 2.5-V/3.3-V low-voltage bus switch with 5-V tolerant level shifter, TSSOP-48 | [Datasheet](https://www.ti.com/lit/ds/symlink/sn74cb3t16210.pdf) |
| SN74CB3T16210DGV | 20-bit FET bus switch, 2.5-V/3.3-V low-voltage bus switch with 5-V tolerant level shifter, TVSOP-48 | [Datasheet](https://www.ti.com/lit/ds/symlink/sn74cb3t16210.pdf) |
| SN74CB3T16211DGG | 24-bit FET bus switch, 2.5-V/3.3-V low-voltage bus switch with 5-V tolerant level shifter, TSSOP-56 | [Datasheet](http://www.ti.com/lit/ds/symlink/sn74cb3t16211.pdf) |
| SN74CB3T16211DGV | 24-bit FET bus switch, 2.5-V/3.3-V low-voltage bus switch with 5-V tolerant level shifter, TVSOP-56 | [Datasheet](http://www.ti.com/lit/ds/symlink/sn74cb3t16211.pdf) |
| SN74CB3T16211DL | 24-bit FET bus switch, 2.5-V/3.3-V low-voltage bus switch with 5-V tolerant level shifter, SSOP-56 | [Datasheet](http://www.ti.com/lit/ds/symlink/sn74cb3t16211.pdf) |
| SN74CB3T3245DBQ | 8-bit FET bus switch, 2.5-V/3.3-V low-voltage with 5-V tolerant level shifter, SSOP-20 | [Datasheet](https://www.ti.com/lit/ds/symlink/sn74cb3t3245.pdf) |
| SN74CB3T3245DGV | 8-bit FET bus switch, 2.5-V/3.3-V low-voltage with 5-V tolerant level shifter, TVSOP-20 | [Datasheet](https://www.ti.com/lit/ds/symlink/sn74cb3t3245.pdf) |
| SN74CB3T3245DW | 8-bit FET bus switch, 2.5-V/3.3-V low-voltage with 5-V tolerant level shifter, SOIC-20W | [Datasheet](https://www.ti.com/lit/ds/symlink/sn74cb3t3245.pdf) |
| SN74CB3T3245PW | 8-bit FET bus switch, 2.5-V/3.3-V low-voltage with 5-V tolerant level shifter, TSSOP-20 | [Datasheet](https://www.ti.com/lit/ds/symlink/sn74cb3t3245.pdf) |
| SN74LV1T125DBV | Single Power Supply Single Buffer Gate with 3-state Output CMOS Logic Level Shifter, SOT-23-5 | [Datasheet](http://www.ti.com/lit/ds/symlink/sn74lv1t125.pdf) |
| SN74LV1T125DCK | Single Power Supply Single Buffer Gate with 3-state Output CMOS Logic Level Shifter, SC-70-5 | [Datasheet](http://www.ti.com/lit/ds/symlink/sn74lv1t125.pdf) |
| SN74LV1T126DBV | Single Power Supply Single Buffer Gate with 3-state Output CMOS Logic Level Shifter, SOT-23-5 | [Datasheet](https://www.ti.com/lit/ds/symlink/sn74lv1t126.pdf) |
| SN74LV1T126DCK | Single Power Supply Single Buffer Gate with 3-state Output CMOS Logic Level Shifter, SC-70-5 | [Datasheet](https://www.ti.com/lit/ds/symlink/sn74lv1t126.pdf) |
| SN74LV1T34DBV | Single Power Supply Single Buffer gate CMOS Logic Level Shifter, SOT-23-5 | [Datasheet](http://www.ti.com/lit/ds/symlink/sn74lv1t34.pdf) |
| SN74LV1T34DCK | Single Power Supply Single Buffer gate CMOS Logic Level Shifter, SC-70-5 | [Datasheet](http://www.ti.com/lit/ds/symlink/sn74lv1t34.pdf) |
| SN74LVC16T245DGG | 16-bit dual supply translating transceiver, 3-state, TSSOP-48 | [Datasheet](https://www.ti.com/lit/ds/symlink/sn74lvc16t245.pdf) |
| SN74LVC16T245DGV | 16-bit dual supply translating transceiver, 3-state, TVSOP-48 | [Datasheet](https://www.ti.com/lit/ds/symlink/sn74lvc16t245.pdf) |
| SN74LVC16T245DL | 16-bit dual supply translating transceiver, 3-state, SSOP-48 | [Datasheet](https://www.ti.com/lit/ds/symlink/sn74lvc16t245.pdf) |
| SN74LVC8T245DB | 8-bit dual supply translating transceiver, 3-state, SSOP-24 | [Datasheet](http://www.ti.com/lit/ds/symlink/sn74lvc8t245.pdf) |
| SN74LVC8T245DBQ | 8-bit dual supply translating transceiver, 3-state, SSOP-24 | [Datasheet](http://www.ti.com/lit/ds/symlink/sn74lvc8t245.pdf) |
| SN74LVC8T245DGV | 8-bit dual supply translating transceiver, 3-state, TVSOP-24 | [Datasheet](http://www.ti.com/lit/ds/symlink/sn74lvc8t245.pdf) |
| SN74LVC8T245PW | 8-bit dual supply translating transceiver, 3-state, TSSOP-24 | [Datasheet](http://www.ti.com/lit/ds/symlink/sn74lvc8t245.pdf) |
| SN74LVCH8T245DB | 8-bit dual supply translating transceiver, 3-state, bus hold, SSOP-24 | [Datasheet](http://www.ti.com/lit/ds/symlink/sn74lvch8t245.pdf) |
| SN74LVCH8T245DGV | 8-bit dual supply translating transceiver, 3-state, bus hold, TVSOP-24 | [Datasheet](http://www.ti.com/lit/ds/symlink/sn74lvch8t245.pdf) |
| SN74LVCH8T245PW | 8-bit dual supply translating transceiver, 3-state, bus hold, TSSOP-24 | [Datasheet](http://www.ti.com/lit/ds/symlink/sn74lvch8t245.pdf) |
| SNES_Cartridge | SNES/SFC cartridge edge connector |  |
| SP0504SHTG | 0.85pF TVS Diode Array, SOT-23-6 | [Datasheet](https://m.littelfuse.com/~/media/electronics/datasheets/tvs_diode_arrays/littelfuse_tvs_diode_array_sp0504s_datasheet.pdf.pdf) |
| SP3003-02JTG | 0.65 pF TVS Diode Array, SC-70-5 | [Datasheet](https://m.littelfuse.com/~/media/electronics/datasheets/tvs_diode_arrays/littelfuse_tvs_diode_array_sp3003_datasheet.pdf.pdf) |
| SST39LF010-70-4x-NH | 1 Mbit (128k x 8) 3.0-3.6V Multi-Purpose Flash, 70 ns, PLCC-32 | [Datasheet](https://ww1.microchip.com/downloads/en/DeviceDoc/20005023B.pdf) |
| SST39LF010-70-4x-WH | 1 Mbit (128k x 8) 3.0-3.6V Multi-Purpose Flash, 70 ns, TSOP-I 32-pin | [Datasheet](https://ww1.microchip.com/downloads/en/DeviceDoc/20005023B.pdf) |
| SST39LF020-70-4x-NH | 2 Mbit (256k x 8) 3.0-3.6V Multi-Purpose Flash, 70 ns, PLCC-32 | [Datasheet](https://ww1.microchip.com/downloads/en/DeviceDoc/20005023B.pdf) |
| SST39LF020-70-4x-WH | 2 Mbit (256k x 8) 3.0-3.6V Multi-Purpose Flash, 70 ns, TSOP-I 32-pin | [Datasheet](https://ww1.microchip.com/downloads/en/DeviceDoc/20005023B.pdf) |
| SST39LF040-70-4x-NH | 4 Mbit (512k x 8) 3.0-3.6V Multi-Purpose Flash, 70 ns, PLCC-32 | [Datasheet](https://ww1.microchip.com/downloads/en/DeviceDoc/20005023B.pdf) |
| SST39LF040-70-4x-WH | 4 Mbit (512k x 8) 3.0-3.6V Multi-Purpose Flash, 70 ns, TSOP-I 32-pin | [Datasheet](https://ww1.microchip.com/downloads/en/DeviceDoc/20005023B.pdf) |
| SST39SF010A-70-4x-NH | 1 Mbit (128k x 8) 4.5-5.5V Multi-Purpose Flash, 70 ns, PLCC-32 | [Datasheet](https://ww1.microchip.com/downloads/en/DeviceDoc/20005022C.pdf) |
| SST39SF010A-70-4x-PH | 1 Mbit (128k x 8) 4.5-5.5V Multi-Purpose Flash, 70 ns, PDIP-32 | [Datasheet](https://ww1.microchip.com/downloads/en/DeviceDoc/20005022C.pdf) |
| SST39SF010A-70-4x-WH | 1 Mbit (128k x 8) 4.5-5.5V Multi-Purpose Flash, 70 ns, TSOP-I 32-pin | [Datasheet](https://ww1.microchip.com/downloads/en/DeviceDoc/20005022C.pdf) |
| SST39SF020A-70-4x-NH | 2 Mbit (256k x 8) 4.5-5.5V Multi-Purpose Flash, 70 ns, PLCC-32 | [Datasheet](https://ww1.microchip.com/downloads/en/DeviceDoc/20005022C.pdf) |
| SST39SF020A-70-4x-PH | 2 Mbit (256k x 8) 4.5-5.5V Multi-Purpose Flash, 70 ns, PDIP-32 | [Datasheet](https://ww1.microchip.com/downloads/en/DeviceDoc/20005022C.pdf) |
| SST39SF020A-70-4x-WH | 2 Mbit (256k x 8) 4.5-5.5V Multi-Purpose Flash, 70 ns, TSOP-I 32-pin | [Datasheet](https://ww1.microchip.com/downloads/en/DeviceDoc/20005022C.pdf) |
| SST39SF040-70-4x-NH | 4 Mbit (512k x 8) 4.5-5.5V Multi-Purpose Flash, 70 ns, PLCC-32 | [Datasheet](https://ww1.microchip.com/downloads/en/DeviceDoc/20005022C.pdf) |
| SST39SF040-70-4x-PH | 4 Mbit (512k x 8) 4.5-5.5V Multi-Purpose Flash, 70 ns, PDIP-32 | [Datasheet](https://ww1.microchip.com/downloads/en/DeviceDoc/20005022C.pdf) |
| SST39SF040-70-4x-WH | 4 Mbit (512k x 8) 4.5-5.5V Multi-Purpose Flash, 70 ns, TSOP-I 32-pin | [Datasheet](https://ww1.microchip.com/downloads/en/DeviceDoc/20005022C.pdf) |
| SST39VF010-70-4x-NH | 1 Mbit (128k x 8) 2.7-3.6V Multi-Purpose Flash, 70 ns, PLCC-32 | [Datasheet](https://ww1.microchip.com/downloads/en/DeviceDoc/20005023B.pdf) |
| SST39VF010-70-4x-WH | 1 Mbit (128k x 8) 2.7-3.6V Multi-Purpose Flash, 70 ns, TSOP-I 32-pin | [Datasheet](https://ww1.microchip.com/downloads/en/DeviceDoc/20005023B.pdf) |
| SST39VF020-70-4x-NH | 2 Mbit (256k x 8) 2.7-3.6V Multi-Purpose Flash, 70 ns, PLCC-32 | [Datasheet](https://ww1.microchip.com/downloads/en/DeviceDoc/20005023B.pdf) |
| SST39VF020-70-4x-WH | 2 Mbit (256k x 8) 2.7-3.6V Multi-Purpose Flash, 70 ns, TSOP-I 32-pin | [Datasheet](https://ww1.microchip.com/downloads/en/DeviceDoc/20005023B.pdf) |
| SST39VF040-70-4x-NH | 4 Mbit (512k x 8) 2.7-3.6V Multi-Purpose Flash, 70 ns, PLCC-32 | [Datasheet](https://ww1.microchip.com/downloads/en/DeviceDoc/20005023B.pdf) |
| SST39VF040-70-4x-WH | 4 Mbit (512k x 8) 2.7-3.6V Multi-Purpose Flash, 70 ns, TSOP-I 32-pin | [Datasheet](https://ww1.microchip.com/downloads/en/DeviceDoc/20005023B.pdf) |
| SST39VF1681-70-4x-B3K | 16 Mbit (2M x 8) 2.7-3.6V Multi-Purpose Flash Plus, Bottom Boot Block, 70 ns, TFBGA-48 | [Datasheet](https://ww1.microchip.com/downloads/en/DeviceDoc/25040A.pdf) |
| SST39VF1681-70-4x-EK | 16 Mbit (2M x 8) 2.7-3.6V Multi-Purpose Flash Plus, Bottom Boot Block, 70 ns, TSOP-I 48-pin | [Datasheet](https://ww1.microchip.com/downloads/en/DeviceDoc/25040A.pdf) |
| SST39VF1682-70-4x-B3K | 16 Mbit (2M x 8) 2.7-3.6V Multi-Purpose Flash Plus, Top Boot Block, 70 ns, TFBGA-48 | [Datasheet](https://ww1.microchip.com/downloads/en/DeviceDoc/20005022C.pdf) |
| SST39VF1682-70-4x-EK | 16 Mbit (2M x 8) 2.7-3.6V Multi-Purpose Flash Plus, Top Boot Block, 70 ns, TSOP-I 48-pin | [Datasheet](https://ww1.microchip.com/downloads/en/DeviceDoc/20005022C.pdf) |
| STM690AM | 5 V Supervisor with Battery Switchover, 4.65V Threshold, Active-Low Reset, Watchdog Input, Power-Fail Comparator, SOIC-8 | [Datasheet](https://www.st.com/resource/en/datasheet/stm690a.pdf) |
| STM690RM | 3 V Supervisor with Battery Switchover, 2.625V Threshold, Active-Low Reset, Watchdog Input, Power-Fail Comparator, SOIC-8 | [Datasheet](https://www.st.com/resource/en/datasheet/stm690t-slsh-s-slsh-r.pdf) |
| STM690SDS | 3 V Supervisor with Battery Switchover, 2.925V Threshold, Active-Low Reset, Watchdog Input, Power-Fail Comparator, TSSOP-8 | [Datasheet](https://www.st.com/resource/en/datasheet/stm802t-slsh-s-slsh-r.pdf) |
| STM690SM | 3 V Supervisor with Battery Switchover, 2.925V Threshold, Active-Low Reset, Watchdog Input, Power-Fail Comparator, SOIC-8 | [Datasheet](https://www.st.com/resource/en/datasheet/stm690t-slsh-s-slsh-r.pdf) |
| STM690TM | 3 V Supervisor with Battery Switchover, 3.075V Threshold, Active-Low Reset, Watchdog Input, Power-Fail Comparator, SOIC-8 | [Datasheet](https://www.st.com/resource/en/datasheet/stm690t-slsh-s-slsh-r.pdf) |
| STM692AM | 5 V Supervisor with Battery Switchover, 4.40V Threshold, Active-Low Reset, Watchdog Input, Power-Fail Comparator, SOIC-8 | [Datasheet](https://www.st.com/resource/en/datasheet/stm692a.pdf) |
| STM703M | 5 V Supervisor with Battery Switchover, 4.65V Threshold, Active-Low Reset, Manual Reset Input, Power-Fail Comparator, SOIC-8 | [Datasheet](https://www.st.com/resource/en/datasheet/stm703.pdf) |
| STM704M | 5 V Supervisor with Battery Switchover, 4.40V Threshold, Active-Low Reset, Manual Reset Input, Power-Fail Comparator, SOIC-8 | [Datasheet](https://www.st.com/resource/en/datasheet/stm704.pdf) |
| STM704RM | 3 V Supervisor with Battery Switchover, 2.625V Threshold, Active-Low Reset, Manual Reset Input, Power-Fail Comparator, SOIC-8 | [Datasheet](https://www.st.com/resource/en/datasheet/stm704t-slsh-s-slsh-r.pdf) |
| STM704SDS | 3 V Supervisor with Battery Switchover, 2.925V Threshold, Active-Low Reset, Manual Reset Input, Power-Fail Comparator, TSSOP-8 | [Datasheet](https://www.st.com/resource/en/datasheet/stm802t-slsh-s-slsh-r.pdf) |
| STM704SM | 3 V Supervisor with Battery Switchover, 2.925V Threshold, Active-Low Reset, Manual Reset Input, Power-Fail Comparator, SOIC-8 | [Datasheet](https://www.st.com/resource/en/datasheet/stm704t-slsh-s-slsh-r.pdf) |
| STM704TM | 3 V Supervisor with Battery Switchover, 3.075V Threshold, Active-Low Reset, Manual Reset Input, Power-Fail Comparator, SOIC-8 | [Datasheet](https://www.st.com/resource/en/datasheet/stm704t-slsh-s-slsh-r.pdf) |
| STM795RM | 3 V Supervisor with Battery Switchover, 2.625V Threshold, Active-Low Open Drain Reset, Chip-enable Gating, SOIC-8 | [Datasheet](https://www.st.com/resource/en/datasheet/stm795t-slsh-s-slsh-r.pdf) |
| STM795SM | 3 V Supervisor with Battery Switchover, 2.925V Threshold, Active-Low Open Drain Reset, Chip-enable Gating, SOIC-8 | [Datasheet](https://www.st.com/resource/en/datasheet/stm795t-slsh-s-slsh-r.pdf) |
| STM795TM | 3 V Supervisor with Battery Switchover, 3.075V Threshold, Active-Low Open Drain Reset, Chip-enable Gating, SOIC-8 | [Datasheet](https://www.st.com/resource/en/datasheet/stm795t-slsh-s-slsh-r.pdf) |
| STM802LM | 5 V Supervisor with Battery Switchover, 4.65V Threshold, Active-Low Reset, Watchdog Input, Power-Fail Comparator, SOIC-8 | [Datasheet](https://www.st.com/resource/en/datasheet/stm802l-slsh-m.pdf) |
| STM802MM | 5 V Supervisor with Battery Switchover, 4.40V Threshold, Active-Low Reset, Watchdog Input, Power-Fail Comparator, SOIC-8 | [Datasheet](https://www.st.com/resource/en/datasheet/stm802l-slsh-m.pdf) |
| STM802RM | 3 V Supervisor with Battery Switchover, 2.625V Threshold, Active-Low Reset, Watchdog Input, Power-Fail Comparator, SOIC-8 | [Datasheet](https://www.st.com/resource/en/datasheet/stm802t-slsh-s-slsh-r.pdf) |
| STM802SM | 3 V Supervisor with Battery Switchover, 2.925V Threshold, Active-Low Reset, Watchdog Input, Power-Fail Comparator, SOIC-8 | [Datasheet](https://www.st.com/resource/en/datasheet/stm802t-slsh-s-slsh-r.pdf) |
| STM802TM | 3 V Supervisor with Battery Switchover, 3.075V Threshold, Active-Low Reset, Watchdog Input, Power-Fail Comparator, SOIC-8 | [Datasheet](https://www.st.com/resource/en/datasheet/stm802t-slsh-s-slsh-r.pdf) |
| STM804RM | 3 V Supervisor with Battery Switchover, 2.625V Threshold, Active-High Open Drain Reset, Watchdog Input, Power-Fail Comparator, SOIC-8 | [Datasheet](https://www.st.com/resource/en/datasheet/stm804t-slsh-s-slsh-r.pdf) |
| STM804SM | 3 V Supervisor with Battery Switchover, 2.925V Threshold, Active-High Open Drain Reset, Watchdog Input, Power-Fail Comparator, SOIC-8 | [Datasheet](https://www.st.com/resource/en/datasheet/stm804t-slsh-s-slsh-r.pdf) |
| STM804TM | 3 V Supervisor with Battery Switchover, 3.075V Threshold, Active-High Open Drain Reset, Watchdog Input, Power-Fail Comparator, SOIC-8 | [Datasheet](https://www.st.com/resource/en/datasheet/stm804t-slsh-s-slsh-r.pdf) |
| STM805LM | 5 V Supervisor with Battery Switchover, 4.65V Threshold, Active-High Reset, Watchdog Input, Power-Fail Comparator, SOIC-8 | [Datasheet](https://www.st.com/resource/en/datasheet/stm805l.pdf) |
| STM805RM | 3 V Supervisor with Battery Switchover, 2.625V Threshold, Active-High Open Drain Reset, Watchdog Input, Power-Fail Comparator, SOIC-8 | [Datasheet](https://www.st.com/resource/en/datasheet/stm805t-slsh-s-slsh-r.pdf) |
| STM805SM | 3 V Supervisor with Battery Switchover, 2.925V Threshold, Active-High Open Drain Reset, Watchdog Input, Power-Fail Comparator, SOIC-8 | [Datasheet](https://www.st.com/resource/en/datasheet/stm805t-slsh-s-slsh-r.pdf) |
| STM805TM | 3 V Supervisor with Battery Switchover, 3.075V Threshold, Active-High Open Drain Reset, Watchdog Input, Power-Fail Comparator, SOIC-8 | [Datasheet](https://www.st.com/resource/en/datasheet/stm805t-slsh-s-slsh-r.pdf) |
| STM806RM | 3 V Supervisor with Battery Switchover, 2.625V Threshold, Active-Low Reset, Manual Reset Input, Power-Fail Comparator, SOIC-8 | [Datasheet](https://www.st.com/resource/en/datasheet/stm806t-slsh-s-slsh-r.pdf) |
| STM806SM | 3 V Supervisor with Battery Switchover, 2.925V Threshold, Active-Low Reset, Manual Reset Input, Power-Fail Comparator, SOIC-8 | [Datasheet](https://www.st.com/resource/en/datasheet/stm806t-slsh-s-slsh-r.pdf) |
| STM806TM | 3 V Supervisor with Battery Switchover, 3.075V Threshold, Active-Low Reset, Manual Reset Input, Power-Fail Comparator, SOIC-8 | [Datasheet](https://www.st.com/resource/en/datasheet/stm806t-slsh-s-slsh-r.pdf) |
| STM817LM | 5 V Supervisor with Battery Switchover, 4.65V Threshold, Active-Low Reset, Watchdog Input, Power-Fail Comparator, SOIC-8 | [Datasheet](https://www.st.com/resource/en/datasheet/stm817l-slsh-m.pdf) |
| STM817MM | 5 V Supervisor with Battery Switchover, 4.40V Threshold, Active-Low Reset, Watchdog Input, Power-Fail Comparator, SOIC-8 | [Datasheet](https://www.st.com/resource/en/datasheet/stm817l-slsh-m.pdf) |
| STM818LM | 5 V Supervisor with Battery Switchover, 4.65V Threshold, Watchdog Input, Active-Low Reset, Chip-enable Gating, SOIC-8 | [Datasheet](https://www.st.com/resource/en/datasheet/stm818l-slsh-m.pdf) |
| STM818MM | 5 V Supervisor with Battery Switchover, 4.40V Threshold, Watchdog Input, Active-Low Reset, Chip-enable Gating, SOIC-8 | [Datasheet](https://www.st.com/resource/en/datasheet/stm818l-slsh-m.pdf) |
| STM819LM | 5 V Supervisor with Battery Switchover, 4.65V Threshold, Active-Low Reset, Manual Reset Input, Power-Fail Comparator, SOIC-8 | [Datasheet](https://www.st.com/resource/en/datasheet/stm819l-slsh-m.pdf) |
| STM819MM | 5 V Supervisor with Battery Switchover, 4.40V Threshold, Active-Low Reset, Manual Reset Input, Power-Fail Comparator, SOIC-8 | [Datasheet](https://www.st.com/resource/en/datasheet/stm819l-slsh-m.pdf) |
| SY6288AAAC | 0.6A, Active-High, Low Loss Power Distribution Switch, SOT-23-5 | [Datasheet](https://datasheet.lcsc.com/szlcsc/Silergy-Corp-SY6288AAAC_C111829.pdf) |
| SY6288BAAC | 0.6A, Active-Low, Low Loss Power Distribution Switch, SOT-23-5 | [Datasheet](https://datasheet.lcsc.com/szlcsc/Silergy-Corp-SY6288AAAC_C111829.pdf) |
| SY6288CAAC | 2A, Active-High, Low Loss Power Distribution Switch, SOT-23-5 | [Datasheet](https://datasheet.lcsc.com/szlcsc/Silergy-Corp-SY6288AAAC_C111829.pdf) |
| SY6288D1AAC | 1.5A, Active-Low, Low Loss Power Distribution Switch, SOT-23-5 | [Datasheet](https://datasheet.lcsc.com/szlcsc/Silergy-Corp-SY6288AAAC_C111829.pdf) |
| SY6288DAAC | 2A, Active-Low, Low Loss Power Distribution Switch, SOT-23-5 | [Datasheet](https://datasheet.lcsc.com/szlcsc/Silergy-Corp-SY6288AAAC_C111829.pdf) |
| SY6288EAAC | 2A, Active-Low, Low Loss Power Distribution Switch, SOT-23-5 | [Datasheet](https://datasheet.lcsc.com/szlcsc/Silergy-Corp-SY6288AAAC_C111829.pdf) |
| Si4435FDY | -12.6A Id, -30V Vds, P-Channel MOSFET, SO-8 | [Datasheet](https://www.vishay.com/docs/75339/si4435fdy.pdf) |
| Si7149ADP | -50A Id, -30V Vds, P-Channel MOSFET, PowerPAK-8 | [Datasheet](https://www.vishay.com/docs/62839/si7149adp.pdf) |
| SiRA01DP | -60A Id, -30V Vds, P-Channel MOSFET, PowerPAK-8 | [Datasheet](https://www.vishay.com/docs/75510/sira01dp.pdf) |
| SiRA28BDP | 38A Id, 30V Vds, N-Channel MOSFET, PowerPAK-8 | [Datasheet](https://www.vishay.com/docs/77395/sira28bdp.pdf) |
| SiRA88DP | 45.5A Id, 30V Vds, N-Channel MOSFET, PowerPAK-8 | [Datasheet](https://www.vishay.com/docs/77777/sira88dp.pdf) |
| TCA6408APW | Low-Voltage 8-Bit I2C and SMBus I/O Expander With Interrupt Output, Reset, and Configuration Registers, TSSOP-16 | [Datasheet](https://www.ti.com/lit/ds/symlink/tca6408a.pdf) |
| TCA6408ARGT | Low-Voltage 8-Bit I2C and SMBus I/O Expander With Interrupt Output, Reset, and Configuration Registers, VQFN-16 | [Datasheet](https://www.ti.com/lit/ds/symlink/tca6408a.pdf) |
| TG-3541CE | 32.768 kHz TCXO oscillator | [Datasheet](https://support.epson.biz/td/api/doc_check.php?dl=app_TG-3541CE&lang=en) |
| TLV2316ID | Dual 10-MHz, Rail-to-Rail Input/Output, Low-Voltage, 1.8-V CMOS Operational Amplifier, SOIC-8 | [Datasheet](http://www.ti.com/lit/ds/symlink/tlv2316.pdf) |
| TLV2316IDGK | Dual 10-MHz, Rail-to-Rail Input/Output, Low-Voltage, 1.8-V CMOS Operational Amplifier, VSSOP-8 | [Datasheet](http://www.ti.com/lit/ds/symlink/tlv2316.pdf) |
| TLV316IDBV | Single 10-MHz, Rail-to-Rail Input/Output, Low-Voltage, 1.8-V CMOS Operational Amplifier, SOT-23-5 | [Datasheet](http://www.ti.com/lit/ds/symlink/tlv316.pdf) |
| TLV316IDCK | Single 10-MHz, Rail-to-Rail Input/Output, Low-Voltage, 1.8-V CMOS Operational Amplifier, SC-70-5 | [Datasheet](http://www.ti.com/lit/ds/symlink/tlv316.pdf) |
| TLV4316ID | Quad 10-MHz, Rail-to-Rail Input/Output, Low-Voltage, 1.8-V CMOS Operational Amplifier, SOIC-14 | [Datasheet](http://www.ti.com/lit/ds/symlink/tlv4316.pdf) |
| TLV4316IPW | Quad 10-MHz, Rail-to-Rail Input/Output, Low-Voltage, 1.8-V CMOS Operational Amplifier, TSSOP-14 | [Datasheet](http://www.ti.com/lit/ds/symlink/tlv4316.pdf) |
| TPS3613-01 | Adjustable Battery-Backup Supervisor for RAM Retention, VSSOP-10 | [Datasheet](http://www.ti.com/lit/ds/symlink/tps3613-01.pdf) |
| TPS3619-33 | Backup-battery supervisors for RAM retention, 3 V, Battery Freshness Seal, TSSOP-8 | [Datasheet](https://www.ti.com/lit/ds/symlink/tps3619.pdf) |
| TPS3619-50 | Backup-battery supervisors for RAM retention, 5 V, Battery Freshness Seal, TSSOP-8 | [Datasheet](https://www.ti.com/lit/ds/symlink/tps3619.pdf) |
| TPS3620-33 | Backup-battery supervisors for RAM retention, 3 V, TSSOP-8 | [Datasheet](https://www.ti.com/lit/ds/symlink/tps3620.pdf) |
| TPS3620-50 | Backup-battery supervisors for RAM retention, 5 V, TSSOP-8 | [Datasheet](https://www.ti.com/lit/ds/symlink/tps3620.pdf) |
| TPS62A01DRLR | 1A/2.4MHz Synchronous Buck Converter, SOT-563 | [Datasheet](https://www.ti.com/lit/ds/symlink/tps62a01.pdf) |
| TPS7A0212PDBV | 200-mA Nanopower Iq Low-Dropout Voltage Regulator with Fast Transient Response, Active Discharge, 1.2V, SOT-23-5 | [Datasheet](https://www.ti.com/lit/ds/symlink/tps7a02.pdf) |
| TPS7A0215PDBV | 200-mA Nanopower Iq Low-Dropout Voltage Regulator with Fast Transient Response, Active Discharge, 1.5V, SOT-23-5 | [Datasheet](https://www.ti.com/lit/ds/symlink/tps7a02.pdf) |
| TPS7A0218DBV | 200-mA Nanopower Iq Low-Dropout Voltage Regulator with Fast Transient Response, 1.8V, SOT-23-5 | [Datasheet](https://www.ti.com/lit/ds/symlink/tps7a02.pdf) |
| TPS7A0218PDBV | 200-mA Nanopower Iq Low-Dropout Voltage Regulator with Fast Transient Response, Active Discharge, 1.8V, SOT-23-5 | [Datasheet](https://www.ti.com/lit/ds/symlink/tps7a02.pdf) |
| TPS7A0220PDBV | 200-mA Nanopower Iq Low-Dropout Voltage Regulator with Fast Transient Response, Active Discharge, 2.0V, SOT-23-5 | [Datasheet](https://www.ti.com/lit/ds/symlink/tps7a02.pdf) |
| TPS7A0222PDBV | 200-mA Nanopower Iq Low-Dropout Voltage Regulator with Fast Transient Response, Active Discharge, 2.2V, SOT-23-5 | [Datasheet](https://www.ti.com/lit/ds/symlink/tps7a02.pdf) |
| TPS7A0225DBV | 200-mA Nanopower Iq Low-Dropout Voltage Regulator with Fast Transient Response, 2.5V, SOT-23-5 | [Datasheet](https://www.ti.com/lit/ds/symlink/tps7a02.pdf) |
| TPS7A0225PDBV | 200-mA Nanopower Iq Low-Dropout Voltage Regulator with Fast Transient Response, Active Discharge, 2.5V, SOT-23-5 | [Datasheet](https://www.ti.com/lit/ds/symlink/tps7a02.pdf) |
| TPS7A0228DBV | 200-mA Nanopower Iq Low-Dropout Voltage Regulator with Fast Transient Response, 2.8V, SOT-23-5 | [Datasheet](https://www.ti.com/lit/ds/symlink/tps7a02.pdf) |
| TPS7A0228PDBV | 200-mA Nanopower Iq Low-Dropout Voltage Regulator with Fast Transient Response, Active Discharge, 2.8V, SOT-23-5 | [Datasheet](https://www.ti.com/lit/ds/symlink/tps7a02.pdf) |
| TPS7A0230PDBV | 200-mA Nanopower Iq Low-Dropout Voltage Regulator with Fast Transient Response, Active Discharge, 3.0V, SOT-23-5 | [Datasheet](https://www.ti.com/lit/ds/symlink/tps7a02.pdf) |
| TPS7A0233DBV | 200-mA Nanopower Iq Low-Dropout Voltage Regulator with Fast Transient Response, 3.3V, SOT-23-5 | [Datasheet](https://www.ti.com/lit/ds/symlink/tps7a02.pdf) |
| TPS7A0233PDBV | 200-mA Nanopower Iq Low-Dropout Voltage Regulator with Fast Transient Response, Active Discharge, 3.3V, SOT-23-5 | [Datasheet](https://www.ti.com/lit/ds/symlink/tps7a02.pdf) |
| TPS7A0236PDBV | 200-mA Nanopower Iq Low-Dropout Voltage Regulator with Fast Transient Response, Active Discharge, 3.6V, SOT-23-5 | [Datasheet](https://www.ti.com/lit/ds/symlink/tps7a02.pdf) |
| TS3USB221RSER | High-Speed USB 2.0 1:2 Multiplexer/Demultiplexer Switch with Single Enable, UQFN-10 | [Datasheet](https://www.ti.com/lit/gpn/ts3usb221) |
| UMP1N | High-speed switching diodes 2 pair Com A, SC-70-5 | [Datasheet](https://fscdn.rohm.com/en/products/databook/datasheet/discrete/diode/switching/ump1ntr-e.pdf) |
| USB3318 | Hi-Speed USB ULPI Transceiver, QFN-24 | [Datasheet](https://ww1.microchip.com/downloads/en/DeviceDoc/3318.pdf) |
| XC2C32A-xQFG32 | Coolrunner-II CPLD, 32 Macrocells, QFN-32 | [Datasheet](https://www.xilinx.com/support/documentation/data_sheets/ds310.pdf) |
| XC2C32A-xVQ44 | Coolrunner-II CPLD, 32 Macrocells, VQFP-44 | [Datasheet](https://www.xilinx.com/support/documentation/data_sheets/ds310.pdf) |
| XC2C64A-xVQ44 | Coolrunner-II CPLD, 64 Macrocells, VQFP-44 | [Datasheet](https://www.xilinx.com/support/documentation/data_sheets/ds311.pdf) |
| XC6420ABxxMR | 150mA Small Dual LDO Regulator with ON/OFF Switch, SOT-23-6 | [Datasheet](https://www.torexsemi.com/file/xc6420/XC6420.pdf) |
<!-- SYMBOLS END -->

## Footprints

<!-- FOOTPRINTS START -->
| Name | WRL 3D model | STEP 3D model |
| - | - | - |
| Amphenol_10018783-x0x00_2x18_P1.00mm_Socket_Vertical |  |  |
| Amphenol_10018783-x0x01_2x32_P1.00mm_Socket_Vertical |  |  |
| Amphenol_10018783-x0x02_2x49_P1.00mm_Socket_Vertical |  |  |
| BNC_TEConnectivity_1337543-0_Horizontal |  |  |
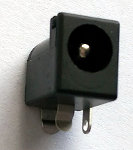
[picture p5: photos/BarrelJack_CUI_PJ-202A_Horizontal.jpg]
BarrelJack_CUI_PJ-202A_Horizontal
| BarrelJack_CUI_PJ-202A_Horizontal <br>  |  |  |
| BatteryHolder_Eagle_12BH002-GR_1x2032 |  | :heavy_check_mark: |
| Battery_CR1616_Horizontal_Tabbed |  | :heavy_check_mark: |
| Battery_CR2025_Horizontal_Tabbed |  | :heavy_check_mark: |
| CP_Seiko_CPH3225A |  |  |
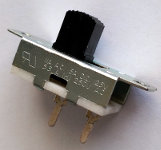
[picture p6: photos/CWIndustries_GF-1123-1110.jpg]
CWIndustries_GF-1123-1110
| CWIndustries_GF-1123-1110 <br>  |  |  |
| DFN-12-1EP_2.5x2.5mm_P0.4mm_EP1.2x1.9mm |  |  |
| DFN-6-1EP_3x3mm_P0.95mm_EP1.35x2.15mm |  |  |
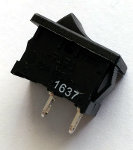
[picture p7: photos/E-Switch_RA12131100.jpg]
E-Switch_RA12131100
| E-Switch_RA12131100 <br>  | :heavy_check_mark: |  |
| EQFP-64-1EP_7x7mm_P0.4mm_EP4.5x4.5mm | :heavy_check_mark: | :heavy_check_mark: |
| EQFP-64-1EP_7x7mm_P0.4mm_EP4.5x4.5mm_ThermalVias |  |  |
| Fanstel_BT832 |  |  |
| Fanstel_BT832F |  |  |
| GameBoy_Cartridge_1x32_P1.50mm_Edge |  |  |
| GameBoy_Cartridge_AGB_1x32_P1.50mm_Socket_Horizontal |  |  |
| GameBoy_Cartridge_AGS_1x32-1MP_P1.50mm_Socket_Horizontal |  |  |
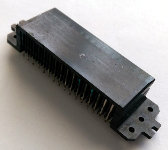
[picture p8: photos/GameBoy_Cartridge_DMG_1x32_P1.50mm_Socket_Horizontal.jpg]
GameBoy_Cartridge_DMG_1x32_P1.50mm_Socket_Horizontal
| GameBoy_Cartridge_DMG_1x32_P1.50mm_Socket_Horizontal <br>  |  |  |
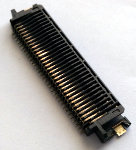
[picture p9: photos/GameBoy_Cartridge_DSLite_1x32_P1.50mm_Socket_Horizontal.jpg]
GameBoy_Cartridge_DSLite_1x32_P1.50mm_Socket_Horizontal
| GameBoy_Cartridge_DSLite_1x32_P1.50mm_Socket_Horizontal <br>  |  |  |
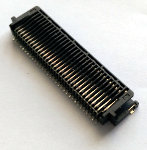
[picture p10: photos/GameBoy_Cartridge_DX-37787_1x32_P1.50mm_Socket_Horizontal.jpg]
GameBoy_Cartridge_DX-37787_1x32_P1.50mm_Socket_Horizontal
| GameBoy_Cartridge_DX-37787_1x32_P1.50mm_Socket_Horizontal <br>  |  |  |
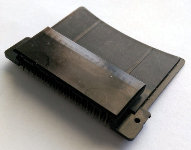
[picture p11: photos/GameBoy_Cartridge_SGB-SGB2_1x32_P1.50mm_Socket_Horizontal.jpg]
GameBoy_Cartridge_SGB-SGB2_1x32_P1.50mm_Socket_Horizontal
| GameBoy_Cartridge_SGB-SGB2_1x32_P1.50mm_Socket_Horizontal <br>  |  |  |
| GameBoy_LinkPort_DMG_Horizontal |  |  |
| GameBoy_LinkPort_MGB_Horizontal |  |  |
| GlobalTop_FGPMMOPA6H |  |  |
| Heatsink_AAVID_573100_TO-252 |  |  |
| ISSI_TSOP-I-28_11.8x8mm_P0.55mm | :heavy_check_mark: | :heavy_check_mark: |
| Infineon_SOT-343_SC-82 |  |  |
| JEITA_QFP-64_12x12mm_P0.65mm | :heavy_check_mark: | :heavy_check_mark: |
| LED_LUXEON-2835 |  |  |
| L_Bourns_SRF0703 |  |  |
| L_Coilcraft_SER1512 |  |  |
| L_CommonMode_TDK_ACM2520-3P_L2.5mm_W2.0mm_Px2.3mm_Py0.65mm |  |  |
| L_CommonMode_TDK_ACM4532-3P_L4.5mm_W3.2mm_Px4.1mm_Py1.7mm |  |  |
| L_Eaton_DRQ73 |  |  |
| L_Eaton_DRQ74 |  |  |
| L_Hotland_MCW-0630 | :heavy_check_mark: | :heavy_check_mark: |
| L_Hotland_MCW-0650 | :heavy_check_mark: | :heavy_check_mark: |
| L_Sunltech_SLO0520H |  |  |
| L_Sunltech_SLW40xx |  |  |
| Lattice_QFN-84-1EP_7x7mm_P0.5mm_EP4.4x4.4mm |  |  |
| Micrel_VQFN-20-1EP_3x4mm_P0.5mm_EP1.6x2.6mm |  |  |
| Micron_TFBGA-60_8x16mm_Layout8x15_P0.8mm |  |  |
| Micron_VFBGA-54_8x14mm_Layout9x9_P0.8mm |  |  |
| Micron_VFBGA-54_8x8mm_Layout9x9_P0.8mm |  |  |
| Molex_19708-400X_Vertical | :heavy_check_mark: |  |
| Molex_19708-401X_Vertical <br> Molex_19708-401X_Vertical | :heavy_check_mark: |  |
| Molex_CLIK-Mate_213227-32xx_2x16-1MP_P1.50mm_Vertical |  |  |
| Molex_Milli-Grid_87831-44xx_2x22_P2.00mm_Vertical |  |  |
| Molex_Milli-Grid_87832-44xx_2x22_P2.00mm_Vertical |  |  |
| MountingHole_2.3mm |  |  |
| MountingHole_7.2mm |  |  |
| Murata_DA1xxJC |  |  |
| Oscillator_SMD_IQD_IQXO-79x_2.5x2.0mm |  |  |
| Oscillator_SMD_SeikoEpson_TG-3541CE_3.2x2.5mm |  |  |
| PCIExpress_x1_2x18_P1.00mm_Edge |  |  |
| PCIExpress_x4_2x32_P1.00mm_Edge |  |  |
| PCIExpress_x8_2x49_P1.00mm_Edge |  |  |
| Potentiometer_Bourns_3361P_Vertical |  |  |
| Potentiometer_Hokuriku_VG039NCH_Vertical |  |  |
| Rohm_HRP5 |  |  |
| Rohm_QFP-56_10x10mm_P0.65mm | :heavy_check_mark: | :heavy_check_mark: |
| SW_PUSH_4.5mm |  |  |
| SW_SPST_Circle_D6mm_2Segments |  |  |
| SW_SPST_Circle_D6mm_4Segments |  |  |
| SW_SPST_PTS540 |  |  |
| Samtec_IPL1-103-01-x-D_2x03_P2.54mm_Vertical |  |  |
| Samtec_IPL1-106-01-x-S_1x06_P2.54mm_Vertical |  |  |
| Samtec_IPL1-108-01-x-D-RA_2x08_P2.54mm_Vertical |  |  |
| Samtec_PCIE-036-02-x-D-EMS2_2x18_P1.00mm_Horizontal |  |  |
| Sharp_QFP-128_14x20mm_P0.5mm | :heavy_check_mark: | :heavy_check_mark: |
| Sharp_QFP-156_14x20mm_P0.4mm | :heavy_check_mark: | :heavy_check_mark: |
| Sharp_QFP-44_10x10mm_P0.8mm | :heavy_check_mark: | :heavy_check_mark: |
| Sharp_QFP-44_14x14mm_P0.8mm | :heavy_check_mark: | :heavy_check_mark: |
| Sharp_QFP-80_14x20mm_P0.8mm | :heavy_check_mark: | :heavy_check_mark: |
| Sharp_SOIC-24W_8.6x15.4mm_P1.27mm | :heavy_check_mark: | :heavy_check_mark: |
| Sharp_SOIC-28W_8.6x18mm_P1.27mm | :heavy_check_mark: | :heavy_check_mark: |
| Sharp_SSOP-18_6x7.4mm_P0.8mm | :heavy_check_mark: | :heavy_check_mark: |
| TFBGA-126_10.5x13.5mm_Layout12x16_P0.8mm_Ball0.45mm_Pad0.35mm_NSMD | :heavy_check_mark: | :heavy_check_mark: |
| TFBGA-128_11x13mm_Layout12x12_P0.8mm_Ball0.45mm_Pad0.35mm_NSMD | :heavy_check_mark: | :heavy_check_mark: |
| TFBGA-136_10x14mm_Layout12x17_P0.8mm_Ball0.45mm_Pad0.35mm_NSMD | :heavy_check_mark: | :heavy_check_mark: |
| TFBGA-144_10.5x14mm_Layout11x17_P0.8mm_Ball0.45mm_Pad0.35mm_NSMD | :heavy_check_mark: | :heavy_check_mark: |
| TFBGA-144_10x14mm_Layout11x17_P0.8mm_Ball0.45mm_Pad0.35mm_NSMD | :heavy_check_mark: | :heavy_check_mark: |
| TFBGA-144_11x14mm_Layout11x17_P0.8mm_Ball0.45mm_Pad0.35mm_NSMD | :heavy_check_mark: | :heavy_check_mark: |
| TFBGA-144_13x15mm_Layout13x13_P0.8mm_Ball0.45mm_Pad0.35mm_NSMD | :heavy_check_mark: | :heavy_check_mark: |
| TFBGA-195_13x15mm_Layout13x15_P0.8mm_Ball0.45mm_Pad0.35mm_NSMD | :heavy_check_mark: | :heavy_check_mark: |
| TFBGA-221_13x15mm_Layout13x17_P0.8mm_Ball0.45mm_Pad0.35mm_NSMD | :heavy_check_mark: | :heavy_check_mark: |
| TFBGA-252_12x18mm_Layout14x22_P0.8mm_Ball0.45mm_Pad0.35mm_NSMD | :heavy_check_mark: | :heavy_check_mark: |
| TFBGA-272_14x18mm_Layout16x22_P0.8mm_Ball0.45mm_Pad0.35mm_NSMD | :heavy_check_mark: | :heavy_check_mark: |
| TFBGA-316_14x18mm_Layout16x22_P0.8mm_Ball0.45mm_Pad0.35mm_NSMD | :heavy_check_mark: | :heavy_check_mark: |
| TFBGA-40_8x15mm_Layout6x10_P0.8mm_Ball0.3mm_Pad0.25mm_NSMD | :heavy_check_mark: | :heavy_check_mark: |
| TFBGA-48_6x12mm_Layout6x8_P0.8mm_Ball0.3mm_Pad0.25mm_NSMD | :heavy_check_mark: | :heavy_check_mark: |
| TFBGA-48_6x8mm_Layout6x8_P0.8mm_Ball0.45mm_Pad0.35mm_NSMD | :heavy_check_mark: | :heavy_check_mark: |
| TFBGA-48_6x9mm_Layout6x8_P0.8mm_Ball0.3mm_Pad0.25mm_NSMD | :heavy_check_mark: | :heavy_check_mark: |
| TFBGA-48_6x9mm_Layout6x8_P0.8mm_Ball0.45mm_Pad0.35mm_NSMD | :heavy_check_mark: | :heavy_check_mark: |
| TFBGA-48_7x12mm_Layout6x8_P0.8mm_Ball0.45mm_Pad0.35mm_NSMD | :heavy_check_mark: | :heavy_check_mark: |
| TFBGA-48_8x9mm_Layout6x8_P0.8mm_Ball0.3mm_Pad0.25mm_NSMD | :heavy_check_mark: | :heavy_check_mark: |
| TFBGA-48_8x9mm_Layout6x8_P0.8mm_Ball0.45mm_Pad0.35mm_NSMD | :heavy_check_mark: | :heavy_check_mark: |
| TFBGA-56_11.5x14mm_Layout9x11_P0.8mm_Ball0.45mm_Pad0.35mm_NSMD | :heavy_check_mark: | :heavy_check_mark: |
| TFBGA-60_10x10mm_Layout9x11_P0.8mm_Ball0.45mm_Pad0.35mm_NSMD | :heavy_check_mark: | :heavy_check_mark: |
| TFBGA-60_10x16mm_Layout8x8_P0.8mm_Ball0.3mm_Pad0.25mm_NSMD | :heavy_check_mark: | :heavy_check_mark: |
| TFBGA-60_11.5x10mm_Layout9x10_P0.8mm_Ball0.5mm_Pad0.4mm_NSMD | :heavy_check_mark: | :heavy_check_mark: |
| TFBGA-60_11.5x14mm_Layout9x11_P0.8mm_Ball0.45mm_Pad0.35mm_NSMD | :heavy_check_mark: | :heavy_check_mark: |
| TFBGA-60_11x13mm_Layout8x15_P0.8mm_Ball0.45mm_Pad0.35mm_NSMD | :heavy_check_mark: | :heavy_check_mark: |
| TFBGA-60_8x10mm_Layout9x11_P0.8mm_Ball0.45mm_Pad0.35mm_NSMD | :heavy_check_mark: | :heavy_check_mark: |
| TFBGA-60_8x11.5mm_Layout9x11_P0.8mm_Ball0.45mm_Pad0.35mm_NSMD | :heavy_check_mark: | :heavy_check_mark: |
| TFBGA-60_8x12mm_Layout9x11_P0.8mm_Ball0.45mm_Pad0.35mm_NSMD | :heavy_check_mark: | :heavy_check_mark: |
| TFBGA-60_8x14mm_Layout9x11_P0.8mm_Ball0.45mm_Pad0.35mm_NSMD | :heavy_check_mark: | :heavy_check_mark: |
| TFBGA-60_8x16mm_Layout8x15_P0.8mm_Ball0.45mm_Pad0.35mm_NSMD | :heavy_check_mark: | :heavy_check_mark: |
| TFBGA-60_8x9mm_Layout8x8_P0.8mm_Ball0.3mm_Pad0.25mm_NSMD | :heavy_check_mark: | :heavy_check_mark: |
| TFBGA-60_9x16mm_Layout7x15_P0.8mm_Ball0.45mm_Pad0.35mm_NSMD | :heavy_check_mark: | :heavy_check_mark: |
| TFBGA-63_10.5x13mm_Layout10x12_P0.8mm_Ball0.45mm_Pad0.35mm_NSMD | :heavy_check_mark: | :heavy_check_mark: |
| TFBGA-63_11x12mm_Layout8x12_P0.8mm_Ball0.3mm_Pad0.25mm_NSMD | :heavy_check_mark: | :heavy_check_mark: |
| TFBGA-63_8x14mm_Layout8x12_P0.8mm_Ball0.3mm_Pad0.25mm_NSMD | :heavy_check_mark: | :heavy_check_mark: |
| TFBGA-64_8x14mm_Layout8x12_P0.8mm_Ball0.45mm_Pad0.35mm_NSMD | :heavy_check_mark: | :heavy_check_mark: |
| TFBGA-64_9x16mm_Layout9x15_P0.8mm_Ball0.45mm_Pad0.35mm_NSMD | :heavy_check_mark: | :heavy_check_mark: |
| TFBGA-68_10x16.5mm_Layout9x19_P0.8mm_Ball0.45mm_Pad0.35mm_NSMD | :heavy_check_mark: | :heavy_check_mark: |
| TFBGA-78_9x11mm_Layout10x13_P0.8mm_Ball0.5mm_Pad0.4mm_NSMD | :heavy_check_mark: | :heavy_check_mark: |
| TFBGA-78_9x11mm_Layout9x13_P0.8mm_Ball0.45mm_Pad0.35mm_NSMD | :heavy_check_mark: | :heavy_check_mark: |
| TFBGA-80_9x16mm_Layout9x15_P0.8mm_Ball0.45mm_Pad0.35mm_NSMD | :heavy_check_mark: | :heavy_check_mark: |
| TFBGA-84_10x12.5mm_Layout9x15_P0.8mm_Ball0.45mm_Pad0.35mm_NSMD | :heavy_check_mark: | :heavy_check_mark: |
| TFBGA-84_10x16.5mm_Layout9x15_P0.8mm_Ball0.45mm_Pad0.35mm_NSMD | :heavy_check_mark: | :heavy_check_mark: |
| TFBGA-84_11.5x14mm_Layout9x15_P0.8mm_Ball0.45mm_Pad0.35mm_NSMD | :heavy_check_mark: | :heavy_check_mark: |
| TFBGA-84_8x12.5mm_Layout9x15_P0.8mm_Ball0.45mm_Pad0.35mm_NSMD | :heavy_check_mark: | :heavy_check_mark: |
| TFBGA-84_8x14mm_Layout9x15_P0.8mm_Ball0.45mm_Pad0.35mm_NSMD | :heavy_check_mark: | :heavy_check_mark: |
| TFBGA-84_9x12mm_Layout9x10_P0.8mm_Ball0.3mm_Pad0.25mm_NSMD | :heavy_check_mark: | :heavy_check_mark: |
| TFBGA-90_11x13mm_Layout9x15_P0.8mm_Ball0.45mm_Pad0.35mm_NSMD | :heavy_check_mark: | :heavy_check_mark: |
| TFBGA-90_8x13mm_Layout9x15_P0.8mm_Ball0.45mm_Pad0.35mm_NSMD | :heavy_check_mark: | :heavy_check_mark: |
| TFBGA-96_9x14mm_Layout9x16_P0.8mm_Ball0.45mm_Pad0.35mm_NSMD | :heavy_check_mark: | :heavy_check_mark: |
| TSOP-I-32_18.4x8mm_P0.5mm | :heavy_check_mark: | :heavy_check_mark: |
| TSOP-I-48_18.4x12mm_P0.5mm | :heavy_check_mark: | :heavy_check_mark: |
| TSOP-I-56_18.4x14mm_P0.5mm | :heavy_check_mark: | :heavy_check_mark: |
| TSSOP-20-1EP_4.4x6.5mm_P0.65mm_EP2.74x3.86mm |  |  |
| Transformer_GameBoy_DMG |  |  |
| USB_A_GCT_USB1061-GF-L_Horizontal |  |  |
| USB_Micro-AB_Wuerth_629105150921_Horizontal |  |  |
| USB_Micro-AB_Wuerth_629105150921_Horizontal_CircularHoles |  |  |
| USB_Mini-B_Hirose_UX60SC-MB-5ST80_Horizontal |  |  |
| VFBGA-48_6x8mm_Layout6x8_P0.75mm |  |  |
| WDFN-10-1EP_3x3mm_P0.5mm_EP1.2x2.2mm |  |  |
<!-- FOOTPRINTS END -->
