Gekkio/gekkio-kicad-libs/(list of files, cad)

Other CAD files:
openscad/utils.scad
