Gekkio/gekkio-kicad-libs/(commit log)

2017-07-16 Add KiCad project file
2017-07-23 Add 64K SRAM used on Game Boy boards
2017-07-23 Add ispMACH 4000ZE 256 devices
2017-08-04 Fix P1 pin numbers
2017-08-04 Add E-Switch RA12131100
2017-08-04 Add 3D shape for E-Switch RA12131100
2018-02-15 Add some Amphenol PCI Express connectors
2018-04-16 Adjust cartridge slot footprints
2019-01-12 Round connector edges
2019-05-30 Update QFP footprints
2019-06-26 Fix pin type
2020-02-14 More MAX10 devices
2020-03-01 Regenerate QFP footprints
2020-03-01 Update Micron BGA footprints
2020-03-01 Regenerate SO footprints
2020-03-01 Add more regulators
2020-05-16 Fix HRP5 footprint mask
2020-05-16 Various KLC / maintenance fixes
    * Fix KLC violations
    * Use power pin stacking
2020-05-16 Add ADS1274/ADS1278 ADC
2020-05-16 Add MAX6029 voltage reference
2020-05-16 Add AGS cartridge slot footprint
2020-08-19 Add BU48xxG voltage detectors
2020-08-19 Add new battery holders
2020-08-19 Improve footprint solderability
2020-09-12 Improve footprint
2020-09-12 Add some Runic analog switches
2020-10-16 Fix pin mistakes
2021-03-08 Add some PCB SPST footprints
2021-03-08 Regenerate footprint
2021-03-12 Add BNC connector
2021-04-09 Add several JEDEC MO-210Q BGA footprints
2021-04-09 Add several JEDEC MO-142-D footprints
2021-04-13 Update JEDEC-MO-142D footprints + generate models
2021-04-13 Update JEDEC MO-210Q footprints + generate models
2021-04-20 Update JEDEC MO-142D footprint descriptions
2021-08-19 Add Diodes AP3019A
2021-08-19 Fix STM power supervisors, add missing models
2021-08-19 Add one CLIK-Mate footprint
2021-08-19 Update to Kicad 5.99
2021-11-21 Clean up ADC lib
2021-11-21 Clean up battery management lib
2021-11-21 Clean up linear regulator lib
2021-11-21 Clean up reference voltage lib
2021-11-21 Clean up switching regulator lib
2021-11-21 Clean up diode lib
2021-11-21 Clean up specialized device lib
2021-11-21 Clean up LED driver lib
2021-11-21 Clean up specialized connector lib
2021-11-21 Clean up analog switch lib
2021-11-21 Clean up power supervisor lib
2021-11-21 Clean up power protection lib
2021-11-21 Clean up device lib
2021-11-21 Clean up power management lib
2021-11-22 Re-save all footprint libs
2022-01-09 Fix pin position mistake
2022-03-16 Remove upstreamed TSOP-I footprints/models
2022-08-13 Make mounting holes plated
2022-11-30 Add Game Boy Light switch
2022-12-06 Fix KLC issues in some footprints
2022-12-06 Relax footprint check
2022-12-06 Revert "Relax footprint check"
    This reverts commit 70c5d50ece2d222eddd8cbc30751ebe71eb2fed1.
2022-12-06 Ignore footprint check errors
2022-12-25 Add 4.5mm THT push switch
2023-02-20 Upgrade to Kicad 7.0 format
2023-02-20 Bump kicad-library-utils version
2023-08-22 Clarify MGL DP3T doesn't break connection
    Connection is maintained between the two possible pin 2-3 connection
    states.
2023-09-14 Fix output pin type
2023-09-14 Add SNES/SFC connector
2023-11-24 Add some Molex / Samtec footprints
2023-11-24 Fix pin position
2024-02-25 Upgrade to KiCad 8.0
2025-04-13 KiCad 9.0
2026-04-22 Upgrade to Kicad 10
2026-06-29 Add LUXEON 2835 footprint
2026-06-29 Update gitignore for modern KiCad versions
2026-06-29 Use GEKKIO_KICAD_LIBS env in tables
    If this env variable is set in KiCad properly, this allows using Table
    type lib references instead of having to manually maintain every single
    library reference individually.
2026-06-29 Fix 3D model directory in footprints
2026-06-29 Remove Renata SMTU2032-LF footprint
    It's available in KiCad libs
2026-06-29 Use rounded pads in battery footprints
2026-06-29 Include battery size in 12BH002 name
2026-06-30 Add tabbed battery 3D models
